pepelepoisson/LaMule/LaMuleV1/Images/LaMule_V1_CAD_eclate.png

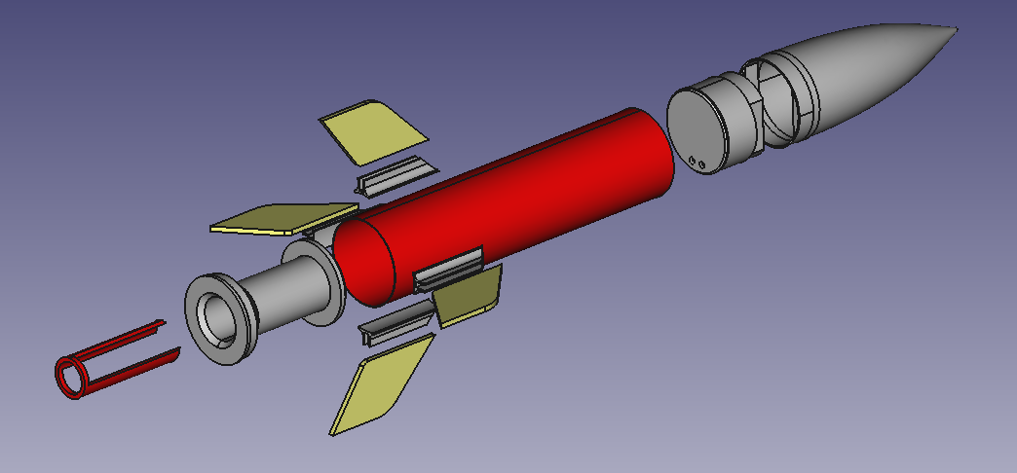
LaMuleV1/Images/LaMule_V1_CAD_eclate.png
