pepelepoisson/LaMule/LaMuleV1/Images/LaMule_V1_post_recuperation.jpg

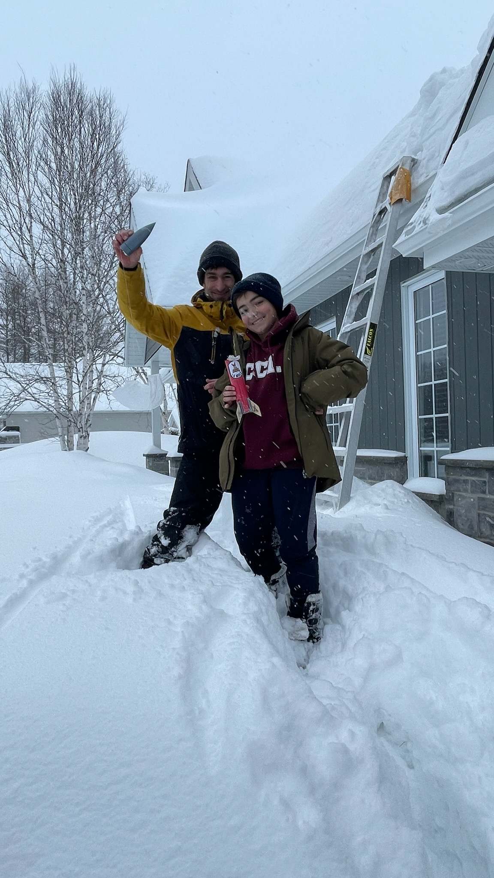
LaMuleV1/Images/LaMule_V1_post_recuperation.jpg
