pepelepoisson/LaMule/LaMuleV1/CAD/Other/coiffe.png

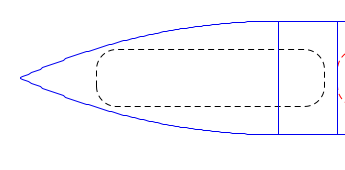
LaMuleV1/CAD/Other/coiffe.png
