pepelepoisson/LaMule/LaMuleV1/Flight_data/LaMule_accelerations_z_vs_phases.png

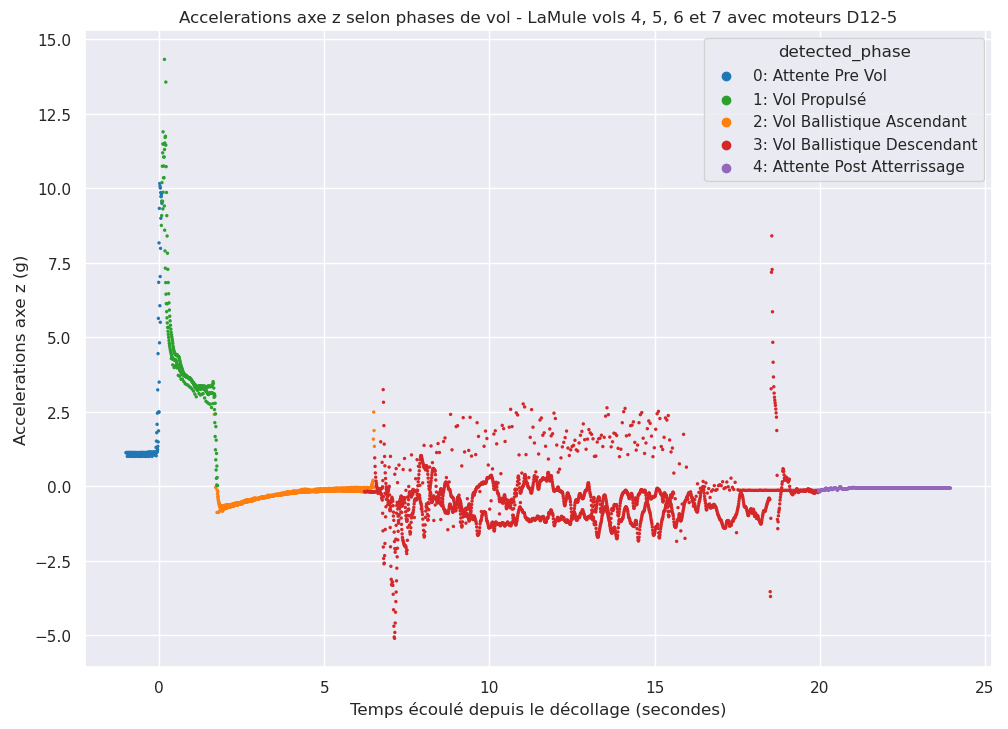
LaMuleV1/Flight_data/LaMule_accelerations_z_vs_phases.png
