pepelepoisson/LaMule/LaMuleV1/Flight_data/LaMule_altitudes_vs_phases.png

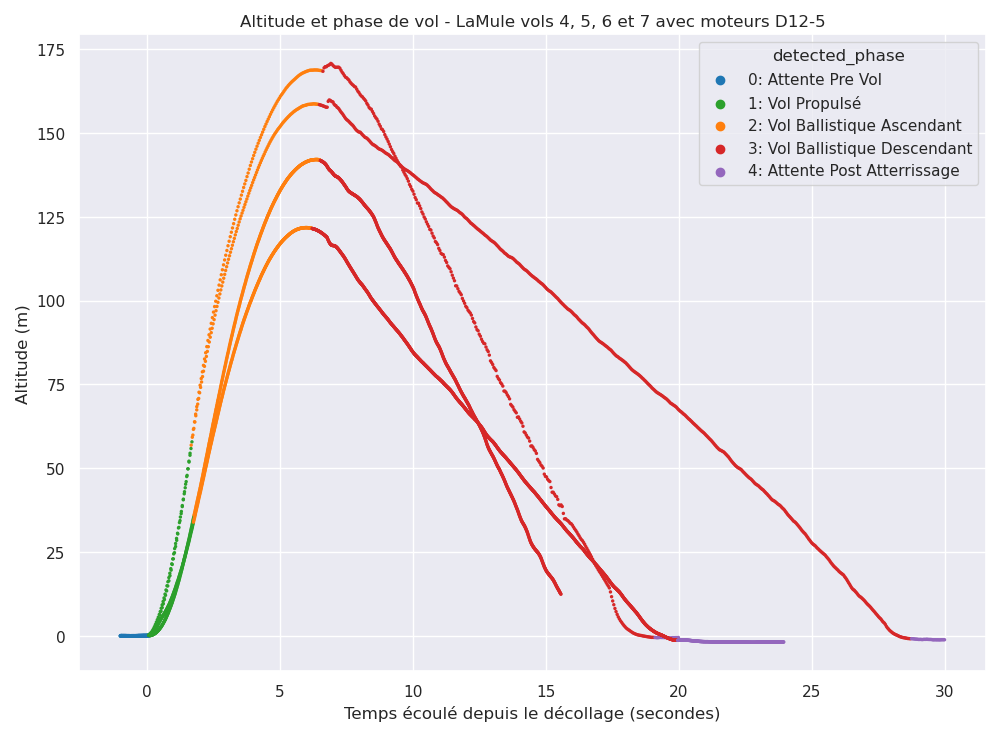
LaMuleV1/Flight_data/LaMule_altitudes_vs_phases.png
