pepelepoisson/LaMule/LaMuleV1/Flight_data/LaMule_altitudes_vs_vols.png

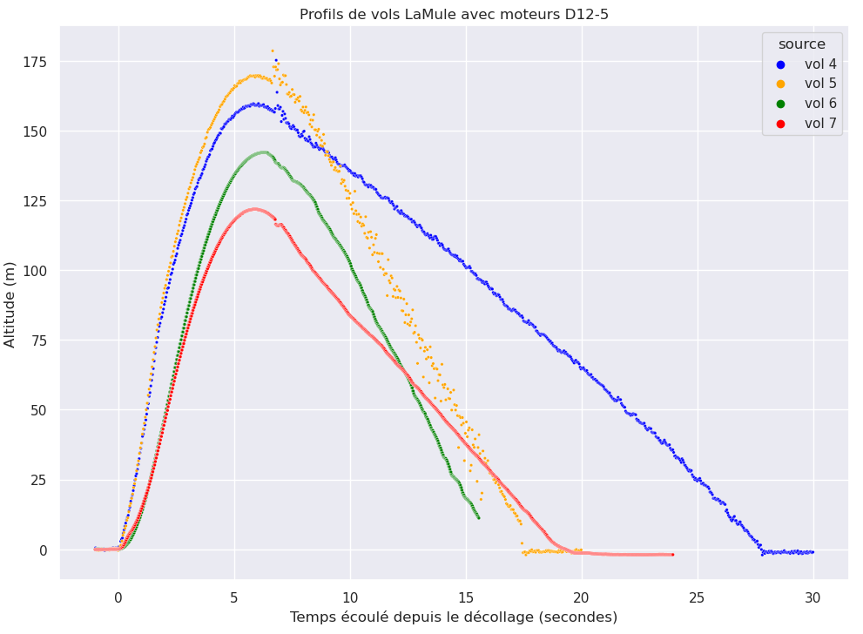
LaMuleV1/Flight_data/LaMule_altitudes_vs_vols.png
