pepelepoisson/LaMule/LaMuleV1/Flight_data/LaMule_vitesses_verticales_vs_phases.png

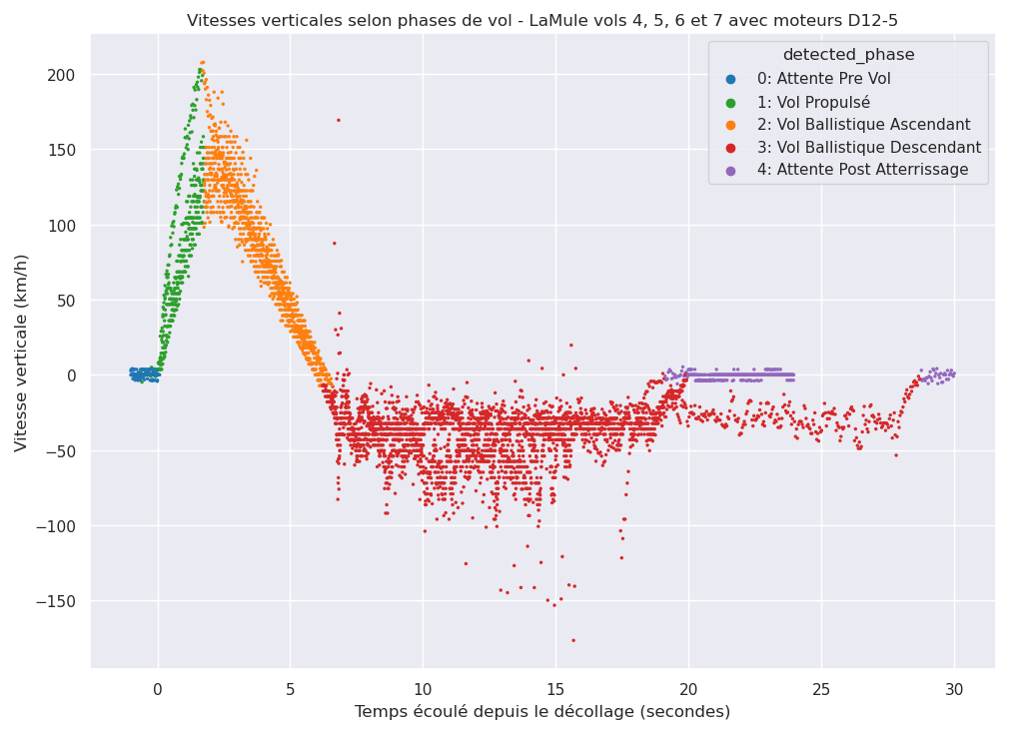
LaMuleV1/Flight_data/LaMule_vitesses_verticales_vs_phases.png
