pepelepoisson/LaMule/LaMuleV1/Flight_data/Profils_acceleration_Z_vols_5_a_7.png

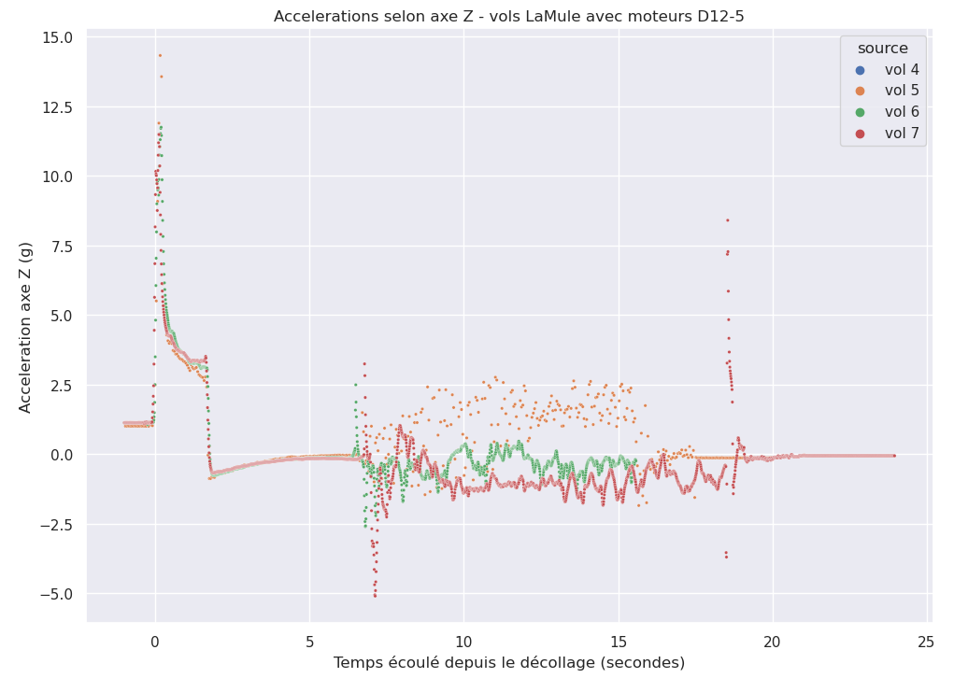
LaMuleV1/Flight_data/Profils_acceleration_Z_vols_5_a_7.png
