pepelepoisson/LaMule/LaMuleV1/Images/800px-EMule_mascot.svg.png

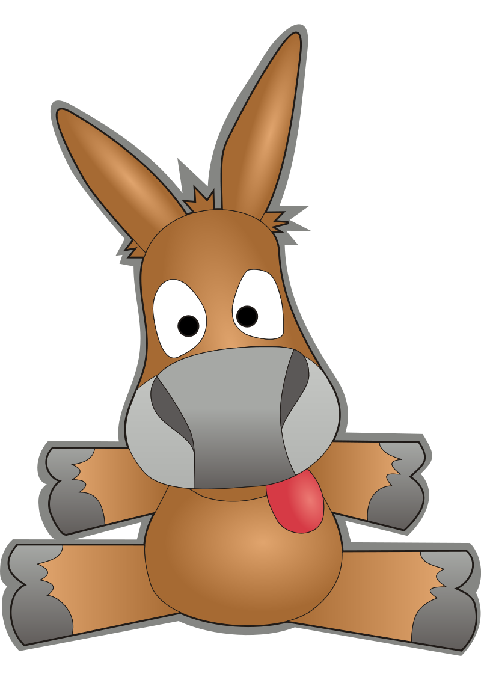
LaMuleV1/Images/800px-EMule_mascot.svg.png
