pepelepoisson/LaMule/LaMuleV1/Images/DSC04824.JPG

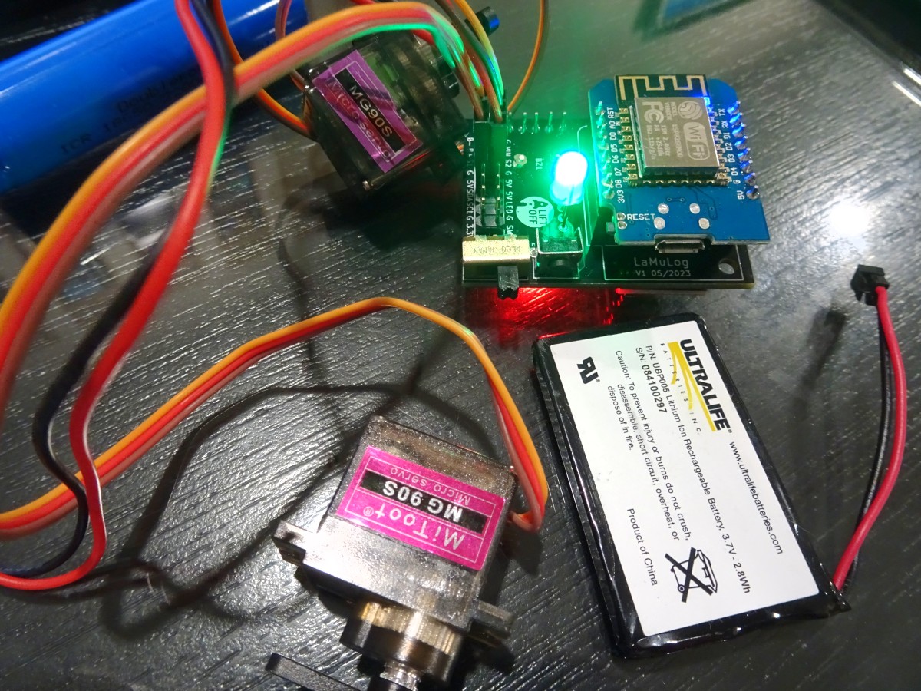
LaMuleV1/Images/DSC04824.JPG
