pepelepoisson/LaMule/LaMuleV1/Images/DSC04825.JPG

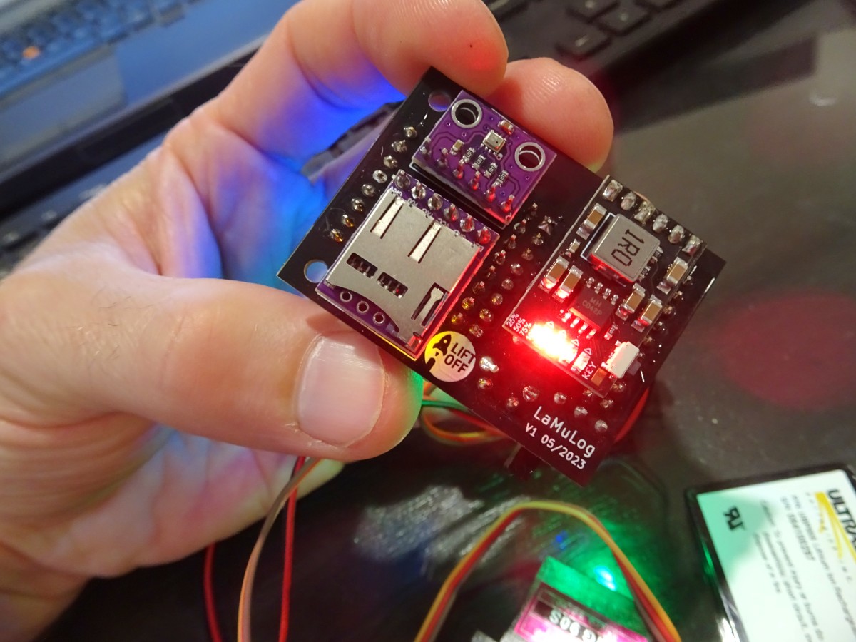
LaMuleV1/Images/DSC04825.JPG
