pepelepoisson/LaMule/LaMuleV1/Images/DSC04826.JPG

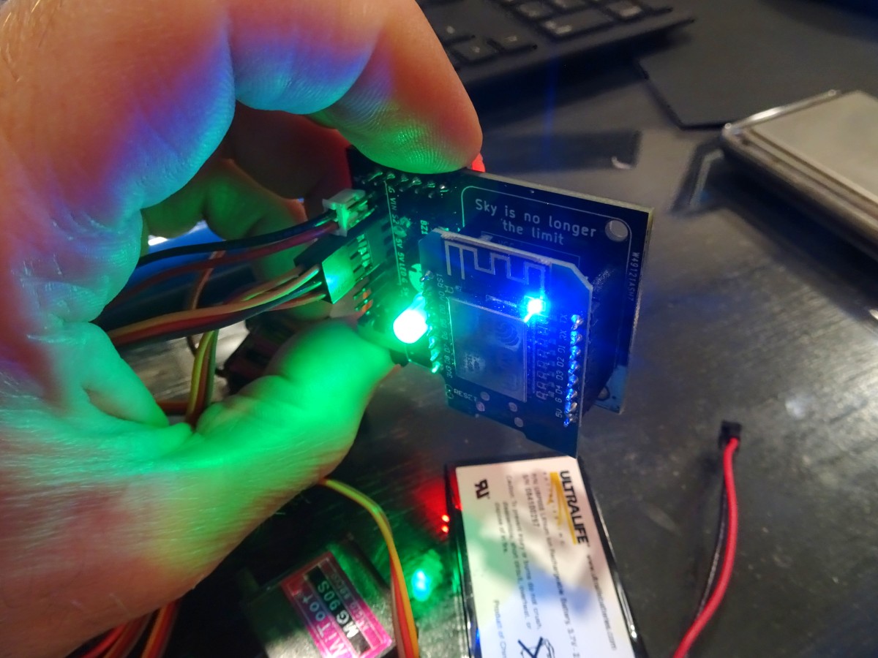
LaMuleV1/Images/DSC04826.JPG
