pepelepoisson/LaMule/LaMuleV1/Images/DSC04827.JPG

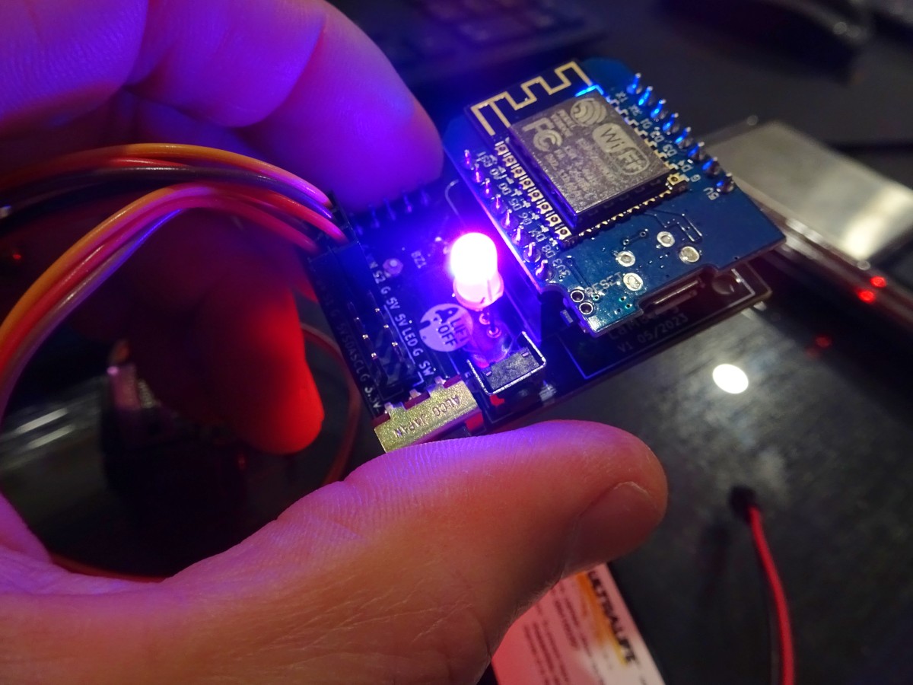
LaMuleV1/Images/DSC04827.JPG
