pepelepoisson/LaMule/LaMuleV1/Images/LacCome.png

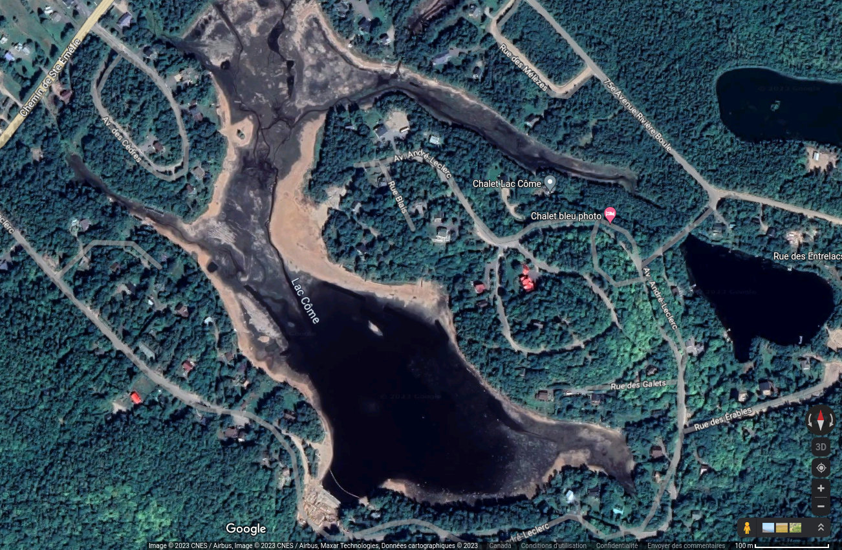
LaMuleV1/Images/LacCome.png
