pepelepoisson/LaMule/LaMuleV1/Images/LaMule_V1_50m.png

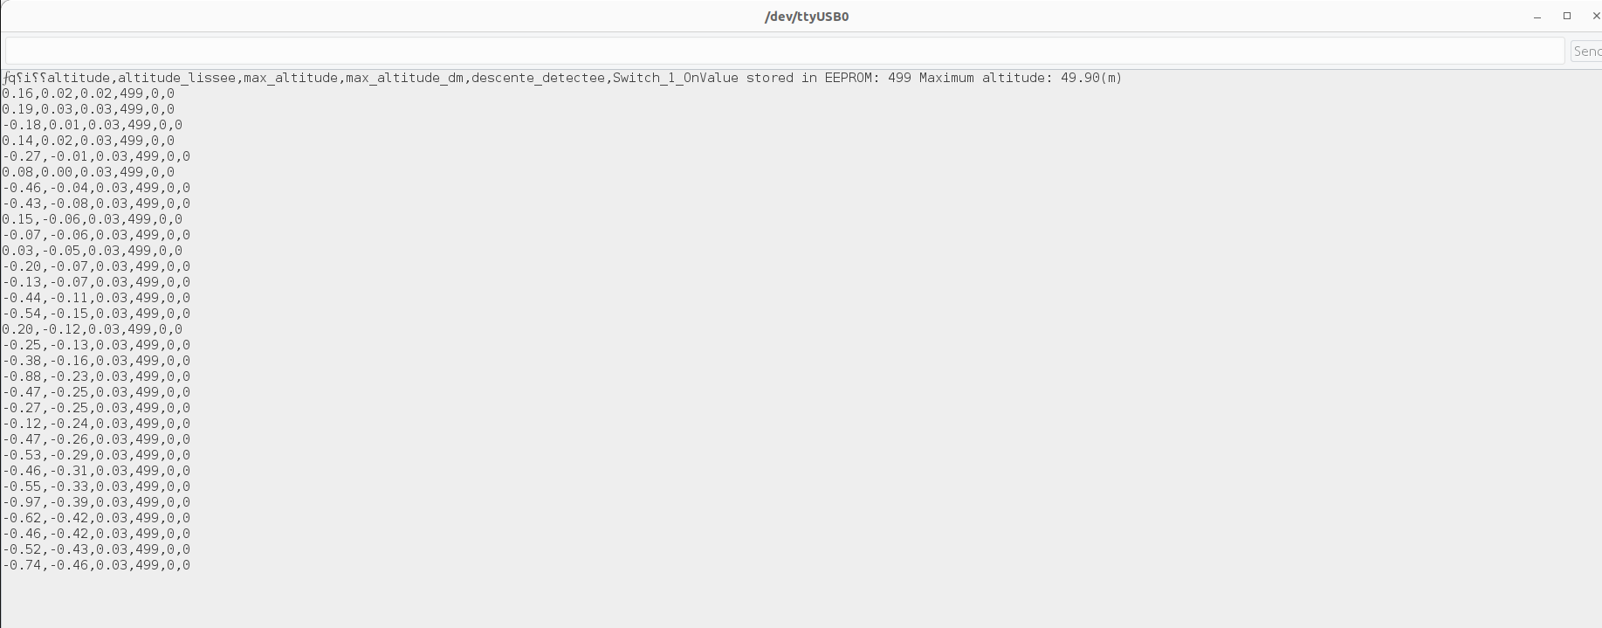
LaMuleV1/Images/LaMule_V1_50m.png
