pepelepoisson/LaMule/LaMuleV1/Images/LaMule_V1_bilan_masse.png

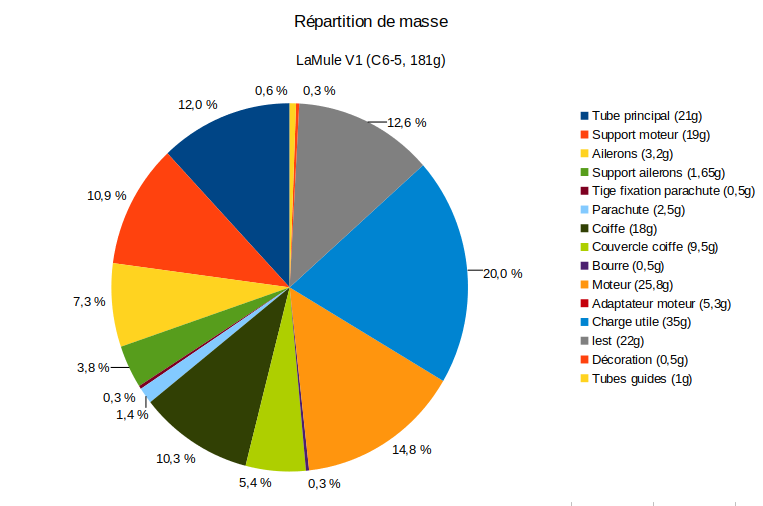
LaMuleV1/Images/LaMule_V1_bilan_masse.png
