pepelepoisson/LaMule/LaMuleV1/Images/LaMule_V1_bilan_masses_simplifie.png

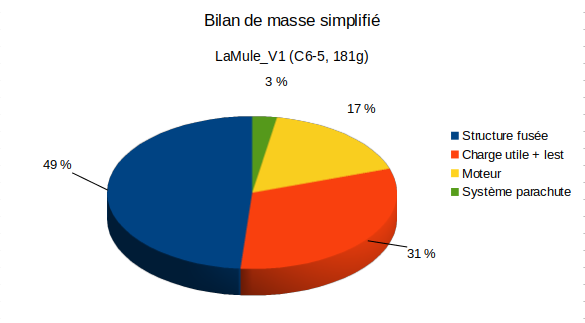
LaMuleV1/Images/LaMule_V1_bilan_masses_simplifie.png
