pepelepoisson/LaMule/LaMuleV1/Images/LaMule_V1_CAD.png

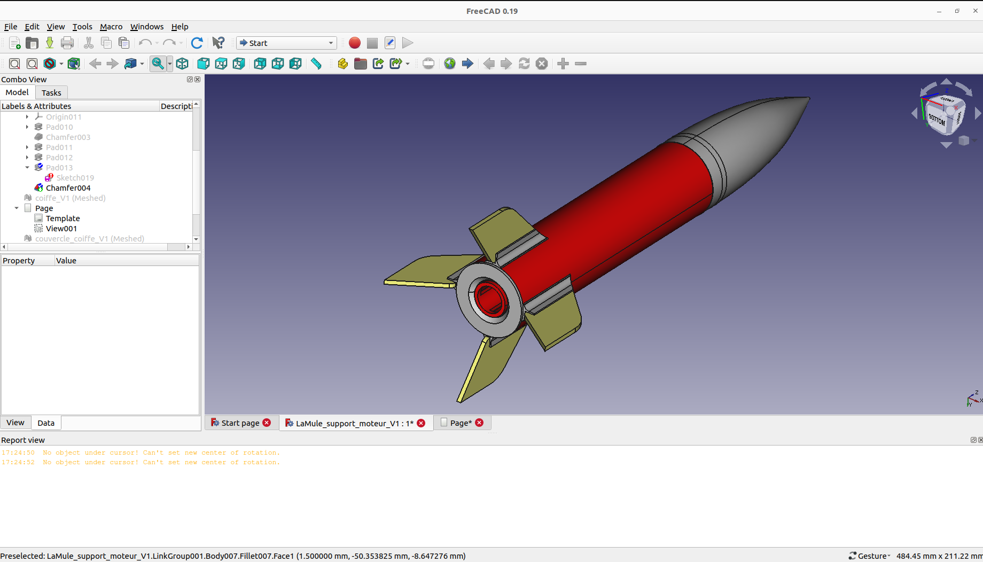
LaMuleV1/Images/LaMule_V1_CAD.png
