pepelepoisson/LaMule/LaMuleV1/Images/LaMule_V1_dessin_technique.png

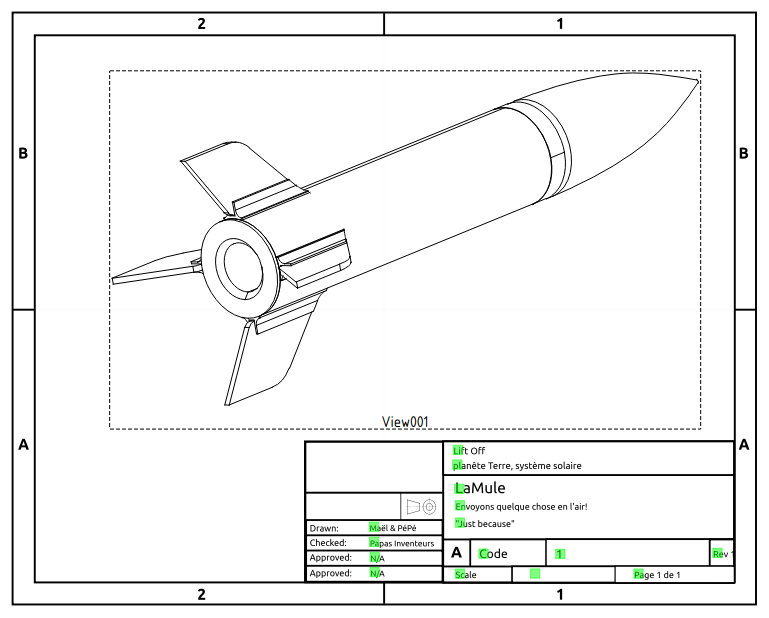
LaMuleV1/Images/LaMule_V1_dessin_technique.png
