pepelepoisson/LaMule/LaMuleV1/Images/LaMule_V1_in_ze_sky.JPG

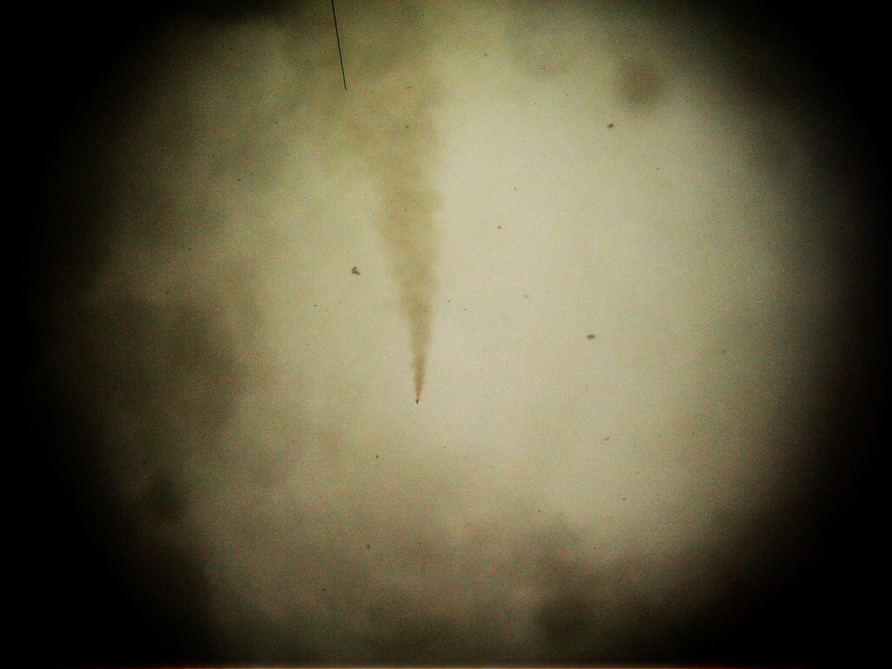
LaMuleV1/Images/LaMule_V1_in_ze_sky.JPG
