pepelepoisson/LaMule/LaMuleV1/Images/LaMule_V1_OpenRocket.png

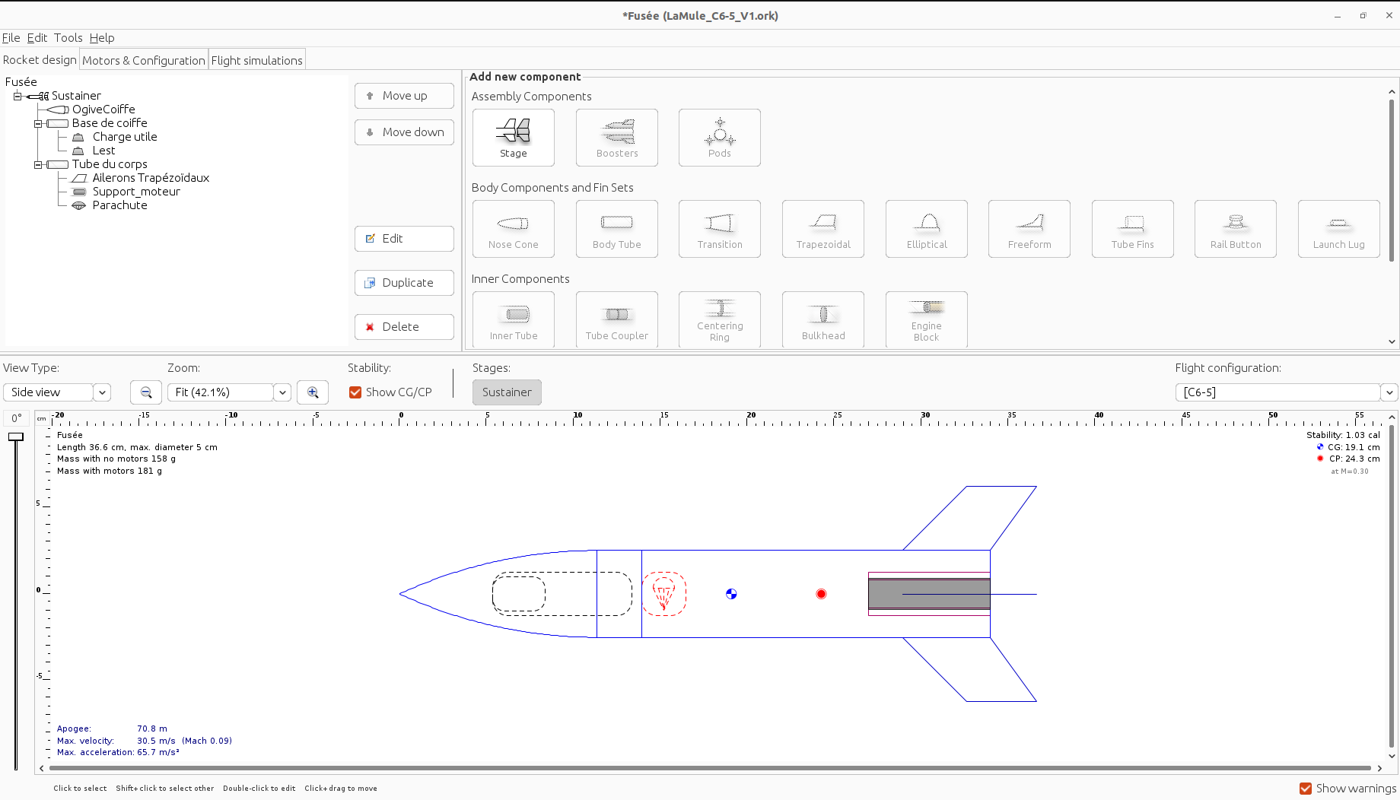
LaMuleV1/Images/LaMule_V1_OpenRocket.png
