pepelepoisson/LaMule/LaMuleV1/Images/LaMule_V1_pre_flight_simulation.png

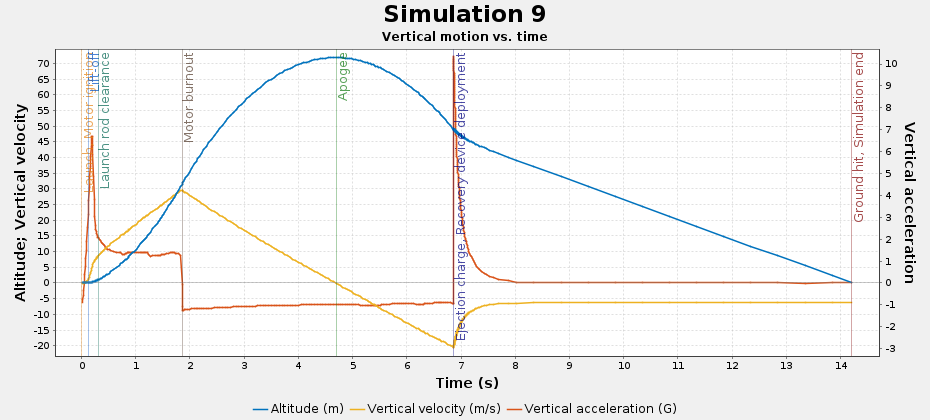
LaMuleV1/Images/LaMule_V1_pre_flight_simulation.png
