pepelepoisson/LaMule/LaMuleV1/Images/LaMule_V1_vitesse_vol1.png

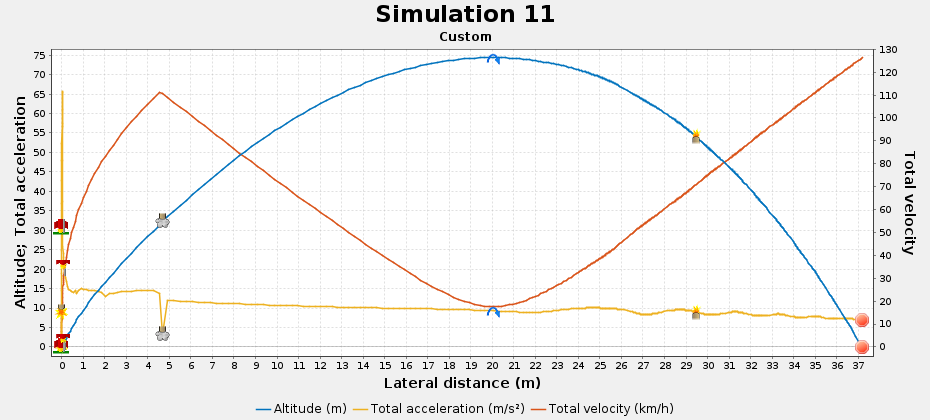
LaMuleV1/Images/LaMule_V1_vitesse_vol1.png
