pepelepoisson/LaMule/LaMuleV1/Images/LaMule_V1_Vol3_post_flight_simulation.png

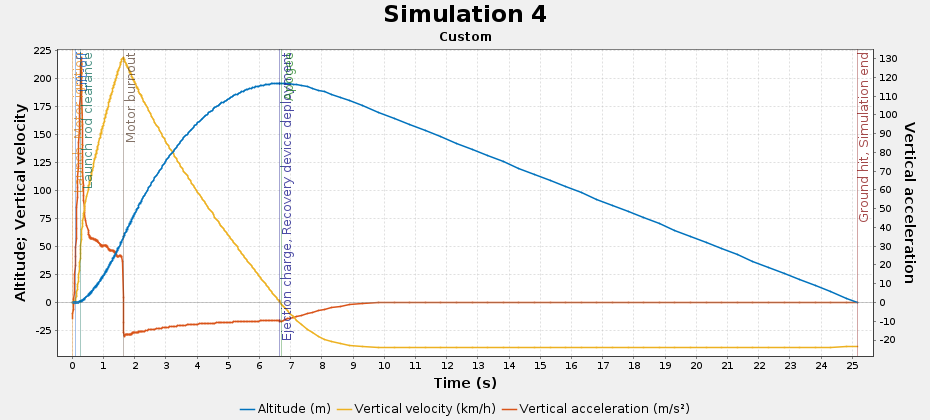
LaMuleV1/Images/LaMule_V1_Vol3_post_flight_simulation.png
