pepelepoisson/LaMule/LaMuleV1/Images/LaMule_Vol3.png

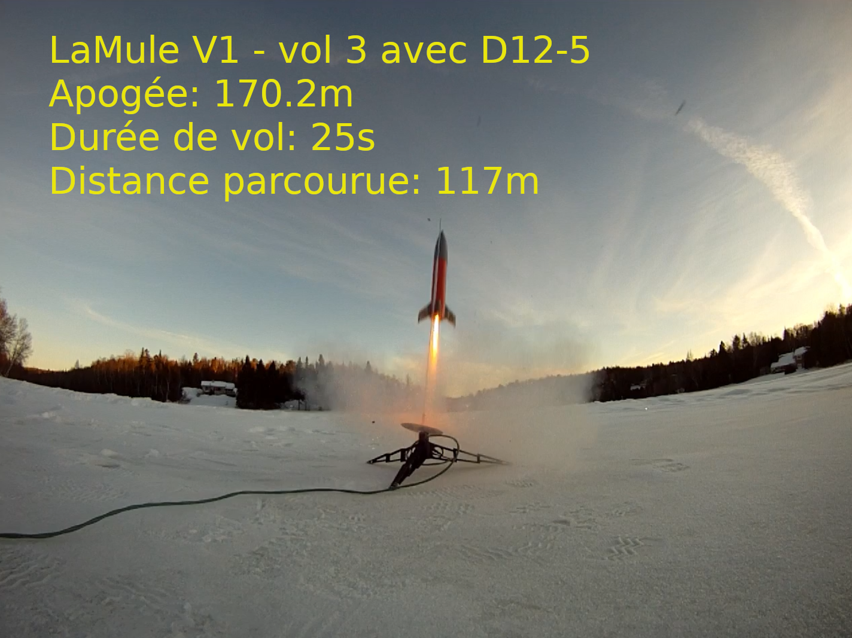
LaMuleV1/Images/LaMule_Vol3.png
