pepelepoisson/LaMule/LaMuleV1/Images/LaMule_Vol4_parachute.png

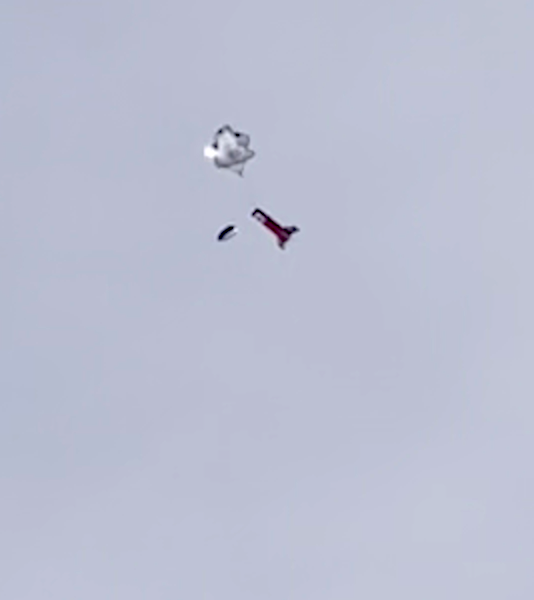
LaMuleV1/Images/LaMule_Vol4_parachute.png
