pepelepoisson/LaMule/LaMuleV1/PCB/LaMulog_esp_compact/3Dmodels/BME280_SENSOR_MODULE.JPG

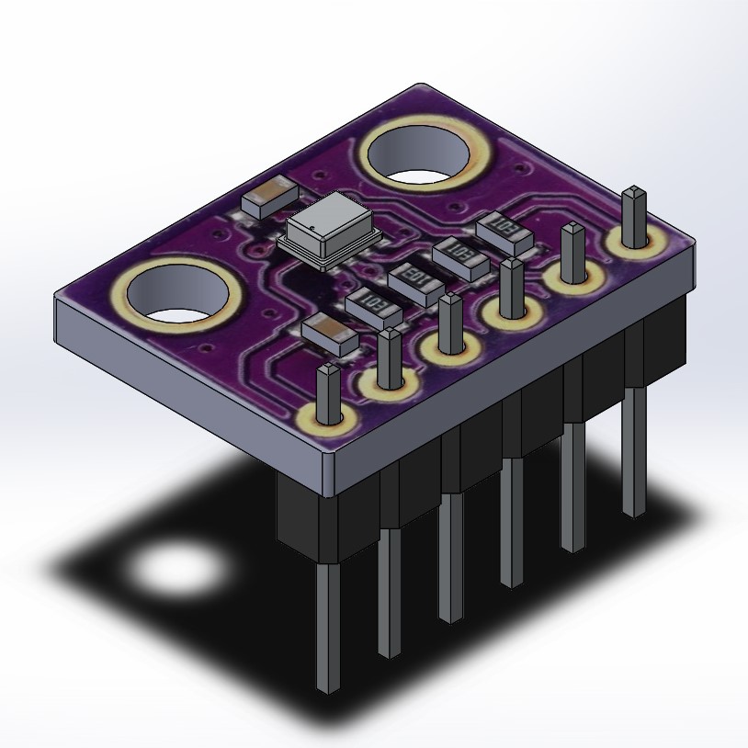
LaMuleV1/PCB/LaMulog_esp_compact/3Dmodels/BME280_SENSOR_MODULE.JPG
