pepelepoisson/LaMule/LaMuleV1/PCB/LaMulog_esp_compact/3Dmodels/MPU 6050 IMU v1.png

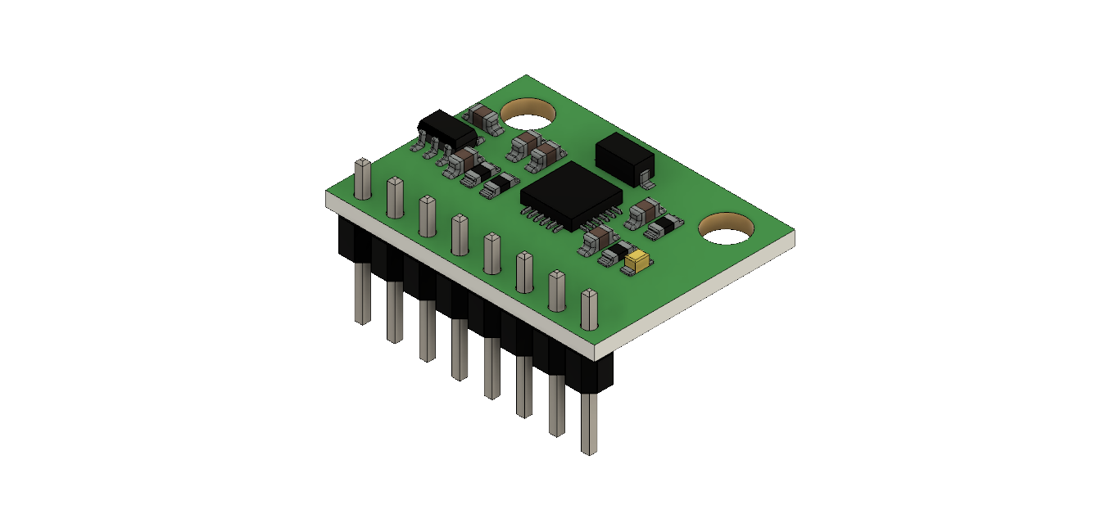
LaMuleV1/PCB/LaMulog_esp_compact/3Dmodels/MPU 6050 IMU v1.png
