pepelepoisson/LaMule/LaMuleV1/PCB/LaMulog_esp_compact/3Dmodels/overview.jpg

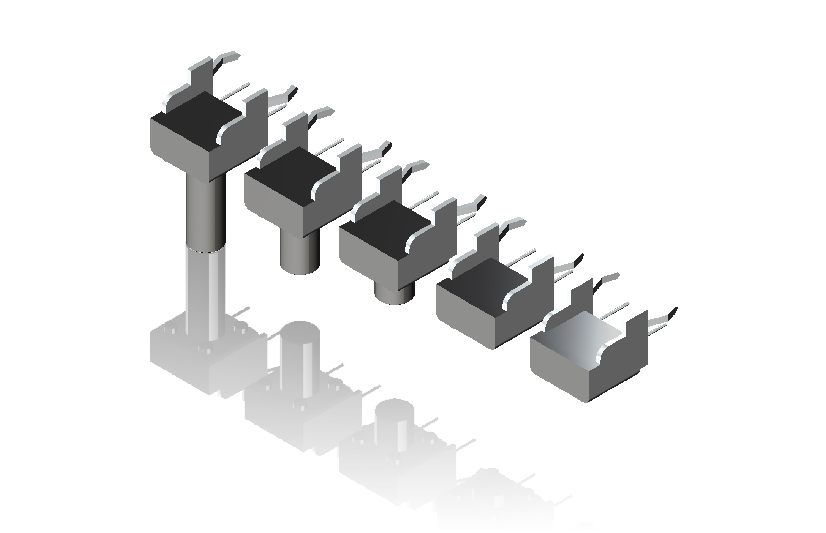
LaMuleV1/PCB/LaMulog_esp_compact/3Dmodels/overview.jpg
