pepelepoisson/LaMule/LaMuleV1/PCB/LaMulog_esp_compact/3Dmodels/switch.PNG

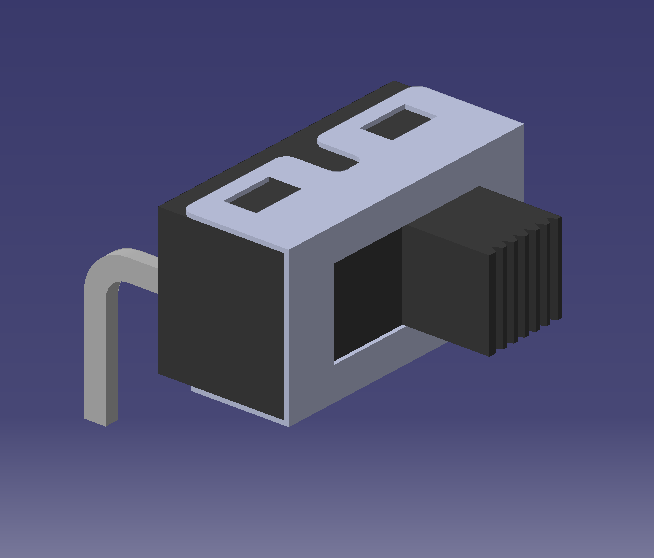
LaMuleV1/PCB/LaMulog_esp_compact/3Dmodels/switch.PNG
