pepelepoisson/LaMule/Projet_fusee.ods

Sheet: Budget de poids électronique
Charges utiles : |  | Masse (g) | dimensions (mm) |  | Energie (Wh) | Concept 1 | Concept 2 | Concept 3
Batteries | Lipo 520mA 3.7V | 10.6 | 49x19x7 |  | 1.924 | 10.6 | 10.6 | 10.6
 | Lipo 756mAh 3.7V | 19.3 | 31x51x6 |  | 2.7972
 | Lipo 18650 2200mAh 3.7V | 48 | 18x650 |  | 8.14
Camera | SQ11 avec micro SD | 10.7 |  |  |  | 10.7 | 10.7
MCU | Nano | 6 | 43x18x8
 | Nano avec radio | 5.3 | 45x18x12
 | Pro mini | 4 | 34x19x5 |  |  | 4 | 4 | 4
Instrumentation | Altimetre GY-BM ME/PM 280 | 1 | 16x12x3 |  |  | 1 | 1
 | Accelerometre GY-521 | 2 | 21x16x3 |  |  | 2 | 2 | 2
Datalogger | Arduino nano logger + RTC | 14 | 94x26x20
 | ID-8122 | 7 | 37x34x6 |  |  | 7 |  | 7
 | Openlog | 3 | 20x16x5 |  |  |  | 3
Servos | MG90S | 11.4 | 32x13x13
Radio | NRF2401 | 2 | 29x16x12 |  |  |  |  | 2
 | NRF2401 grand portee | 10.8 | 49x16x14 | plus antenne 108x10 |  | 10.8 | 10.8
PCB | Breadboard | 4.5 | 80x20x1.6 |  |  | 4.5 | 4.5
Fils etc. |  | 5 |  |  |  | 5 | 5 | 5
Boitier |  | 10 |  |  |  | 10 | 10
Toral |  |  |  |  |  | 65.6 | 61.6 | 30.6
Moteurs :
D12 | https://estesrockets.com/product/001568-d12-7-engines/
 |  |  |  |  |  |  |  | 33.782
2.77623 | 3.60200703832175
5.41257340802685

Sheet: Moteurs
 | 19.6912
 | 58.3 | g
 | 58 | cm
 | 5 | couches
Poids par cm | 1.01 | g
 | 3.6144578313253

Sheet: LaMule_V1.1
Configuration utilisée pour les vols 1 et 2
Bilan de masse |  |  |  |  |  |  |  |  | Vols
Élément | masse unitaire(g) | quantité | masse combinée (g) | Variante | Description |  | Élément | masse combinée (g) | # | Date | Lieu | Configuration | Poids (g) | Apogée (m) | Durée (s) | Distance chute (m) | Trajectoire | Déploiement parachute | Dommages | Notes
Tube principal | 21 | 1 | 21 | 1 | 5 épaisseurs de kraft rouge, colle à bois, diamètre extérieur 50mm, longueur 200mm |  | Tube principal (21g) | 21 | 1 | 2023-03-04 | Lac Côme | V1, C6-5, 181g, altimètre V1 | 181 | 50 |  |  | Stable | Échec | Deux ailerons décollés. | Atterrissage sur le toit du chalet!
Support moteur | 19 | 1 | 19 | 1 | PLA |  | Support moteur (19g) | 19 | 2 | 2023-03-05 | Lac Côme | V1, C6-5, 181g, altimètre V1 | 181 | 3.1 |  | 80 | Stable | Échec | Cône endommagé. | Altimètre n’a pas fonctionné. Atterrissage dans la neige a 80m du pas de tir. Belle vidéo du décollage.
Ailerons | 3.2 | 4 | 12.8 |  |  |  | Ailerons (3,2g) | 12.8 | 3 | 2023-03-11 | Lac Côme | V1, D12-5, altimètre V2, inclinaison 5 degrés. |  | 170.2 | 25.24 | 117 | Stable | Réussi mais n’ouvre pas complètement (fondu) | Un aileron décollé. Parachute partiellement fondu. | Module log mal branché – log non enregistré mais altitude maximale disponible dans la mémoire EEPROM du nano. Le pas de tir bouge latéralement d’un pied au décollage.
Support ailerons | 1.65 | 4 | 6.6 | 1 |  |  | Support ailerons (1,65g) | 6.6 | 4 | 2023-03-12 | Lac Côme | V1, D12-5, altimètre V2, inclinaison 5 degrés. | 214.5 | 160 | 28 | 35 | Stable | Succès total! | Un aileron presque décollé. | Succès! Enregistrement de l’altitude de vol 27 fois par seconde.
Tige fixation parachute | 0.5 | 1 | 0.5 |  |  |  | Tige fixation parachute (0,5g) | 0.5 | 5 | 2023-03-26 | Lac Côme | V1, D12-5, électronique V3 (altimètre + acceleromètre + SD), inclinaison 5 degrés. | 215.5 | 170 | 17.5 | 150 | Stable | Succès mais la coiffe se détache du reste et tombe en chute libre. | Rien mais atteri en 2 morceaux. | Succès! Enregistrement de l’altitude de vol et des données MPU6050 environ 24 fois par seconde. Fusée perdue en haut d’un sapin pendant quelques heures, récupération épique et miraculeuse!
Parachute | 2.5 | 1 | 2.5 |  |  |  | Parachute (2,5g) | 2.5 | 6 | 2023-11-26 | Saint-Lin | V1, D12-5, LamuLog V1 (altimètre + acceleromètre + SD), inclinaison 5 degrés. | 236 | 142 | 16.5 |  | Stable | Le cône est éjécté mais le parachute reste dans le tube de fusée et est endomagé par la chaleur. | 3 ailerons décollés. | Succès du premier test du module LaMulog mais le fichier de log est interrompu bievement au moment du choc de retour à terre (pas de parachute). Altitude maximum consultée immédiatement après le vol via WiFi et page web consultée par ordinateur.
Coiffe | 18 | 1 | 18 |  |  | 1.05882352941176 | Coiffe (18g) | 18 | 7 | 2023-11-26 | Saint-Lin | V1, D12-5, LamuLog V1 (altimètre + acceleromètre + SD), inclinaison 5 degrés. | 236 | 122 | 20 |  | Instable initialement | Le parachute sommairement réparé se déploie partiellement. | Aucun;-) | Succès du premier test du module LaMulog. Altitude maximum consultée immédiatement après le vol via WiFi et page web consultée sur téléphone.
Couvercle coiffe | 9.5 | 1 | 9.5 |  |  |  | Couvercle coiffe (9,5g) | 9.5
Bourre | 2 | 1 | 2 |  |  |  | Bourre (0,5g) | 0.5
Moteur | 25.8 | 1 | 25.8 |  | C6-5 |  | Moteur (25,8g) | 25.8
Adaptateur moteur | 5.3 | 1 | 5.3 | 2 |  |  | Adaptateur moteur (5,3g)
Charge utile | 35 | 1 | 35 |  |  |  | Charge utile (35g) | 35
lest | 22 | 1 | 22 |  |  |  | lest (22g) | 22
Décoration | 0.5 | 1 | 0.5 |  |  |  | Décoration (0,5g) | 0.5
Tubes guides | 1 | 1 | 1 |  |  |  | Tubes guides (1g) | 1
Total théorique |  |  | 181.5
Total constaté |  |  | 181 |  |  |  |  |  | Observations :
Total open rocket |  |  | 181 |  | 3.6 |  |  |  | Remplacer le dispositif d’ancrage des lignes de parachute pour éviter le blocage de la bourre.
Poussée | Poussé moyenne (N) |  | Poids decollage (N) | Ratio poids/poussée |  |  |  |  | Pre-flight check list :
C6-5 | 6 |  | 1.8 | 3.37 |  |  |  |  | Branchements altimètre
 |  |  |  |  |  |  |  |  | Pas de tir stable en place
Bilan de masse simplifié
Sous-ensemble | masse (g)
Structure fusée | 88.4
Charge utile + lest | 57 |  |  |  |  |  | Altimetre | I2C device found at address 0x77
Moteur | 31.1 |  |  |  |  |  | Accéléromètre | I2C device found at address 0x68
Système parachute | 5
Total | 181.5 | 0
Configuration utilisée pour le vol 3
Bilan de masse
Élément | masse unitaire(g) | quantité | masse combinée (g) | Variante | Description
Tube principal | 21 | 1 | 21 | 1 | 5 épaisseurs de kraft rouge, colle à bois, diamètre extérieur 50mm, longueur 200mm
Support moteur | 19 | 1 | 19 | 1 | PLA
Ailerons | 3.2 | 4 | 12.8
Support ailerons | 1.65 | 4 | 6.6 | 1
Tige fixation parachute | 0.5 | 1 | 0.5
Parachute | 5 | 1 | 5
Coiffe | 18 | 1 | 18
Couvercle coiffe | 9.5 | 1 | 9.5
Bourre | 2 | 1 | 2
Moteur | 43.1 | 1 | 43.1 |  | D12-5
Moteur | 25.8 | 0 | 0 |  | C6-5
Adaptateur moteur | 10.8 | 0 | 0 | 1
Adaptateur moteur | 5.3 | 0 | 0 | 2
Charge utile | 35 | 1 | 35
lest | 22 | 1 | 22
Décoration | 0.5 | 1 | 0.5
Tubes guides | 1 | 1 | 1
Total théorique |  |  | 196
Total constaté |  |  | 181
Total open rocket |  |  | 181 |  | 3.6
