pepelepoisson/LaMule/LaMuleV1/PCB/LaMulog_esp_compact/3Dmodels/OpenLog/OpenLog - pins up.SLDASM

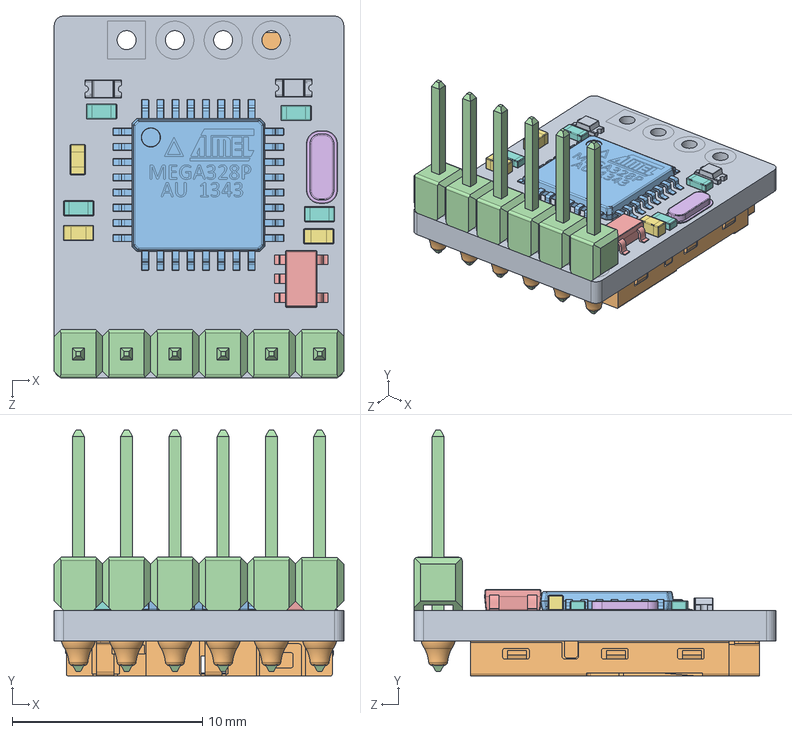
[picture p32: CAD file, 2023-12-13]
LaMuleV1/PCB/LaMulog_esp_compact/3Dmodels/OpenLog/OpenLog - pins up.SLDASM
15.2 x 12.9 x 19.1 mm
OpenLog_PCB
microSDslot.stp
ATmega
Pin Header 1x6 TH Pitch 2.54mm
SOT23-5
cap_603 x 3
res_603 x 4
Surface Mount Chip LED 3.2x1.6mm x 2
solder x 6
