pepelepoisson/LaMule/LaMuleV1/PCB/LaMulog_esp_compact/3Dmodels/OpenLog/OpenLog - basic.SLDASM

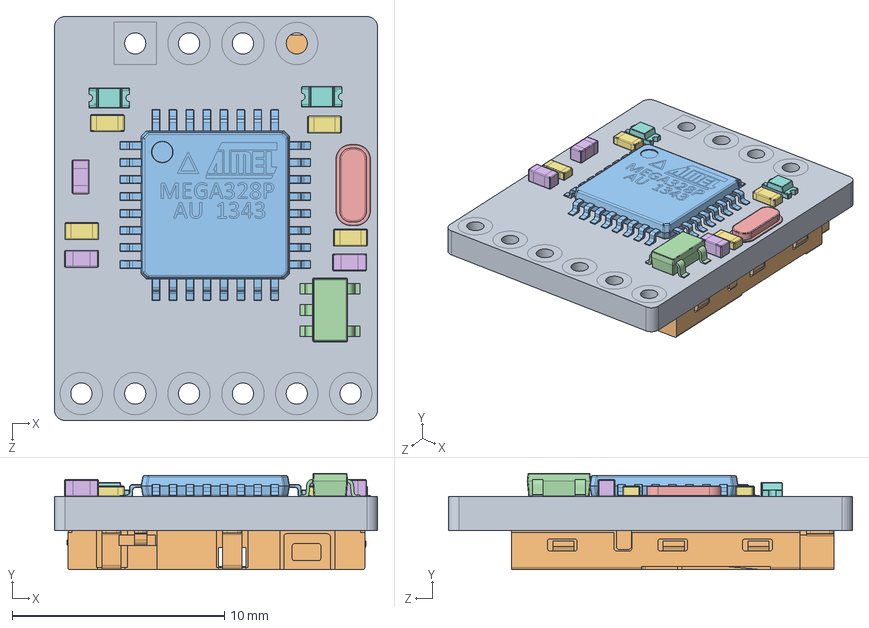
[picture p33: CAD file, 2023-12-13]
LaMuleV1/PCB/LaMulog_esp_compact/3Dmodels/OpenLog/OpenLog - basic.SLDASM
15.2 x 4.55 x 19.1 mm
OpenLog_PCB
microSDslot.stp
ATmega
SOT23-5
cap_603 x 3
res_603 x 4
Surface Mount Chip LED 3.2x1.6mm x 2
