pepelepoisson/LaMule/LaMuleV1/CAD/FreeCAD/LaMule_V1.3.FCStd

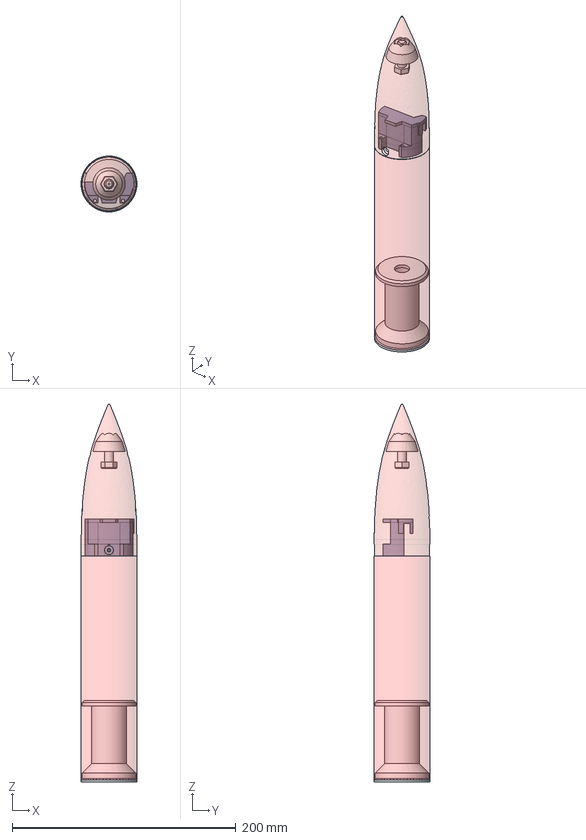
[picture p34: CAD file, 2023-12-13]
LaMuleV1/CAD/FreeCAD/LaMule_V1.3.FCStd
50.0 x 50.0 x 338.0 mm
support_moteur_V1
tube_V1
coiffe_V002
couvercle_coiffe_V003
FixationLaMulog
Support lest
Boulon support lest
Ecrou support lest
