pepelepoisson/LaMule/LaMuleV1/CAD/stl files/LaMule_coiffe_V3.stl

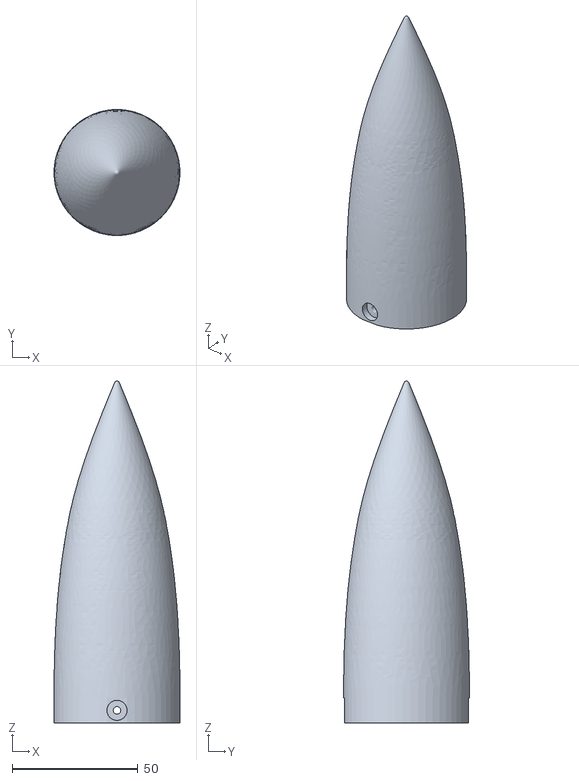
[picture p35: CAD file, 2023-12-13]
LaMuleV1/CAD/stl files/LaMule_coiffe_V3.stl
49.9 x 50.0 x 135.7
