pepelepoisson/LaMule/LaMuleV1/PCB/LaMulog_esp_compact/3Dmodels/GY-BME/P280, 6-PIN-Version v4.step

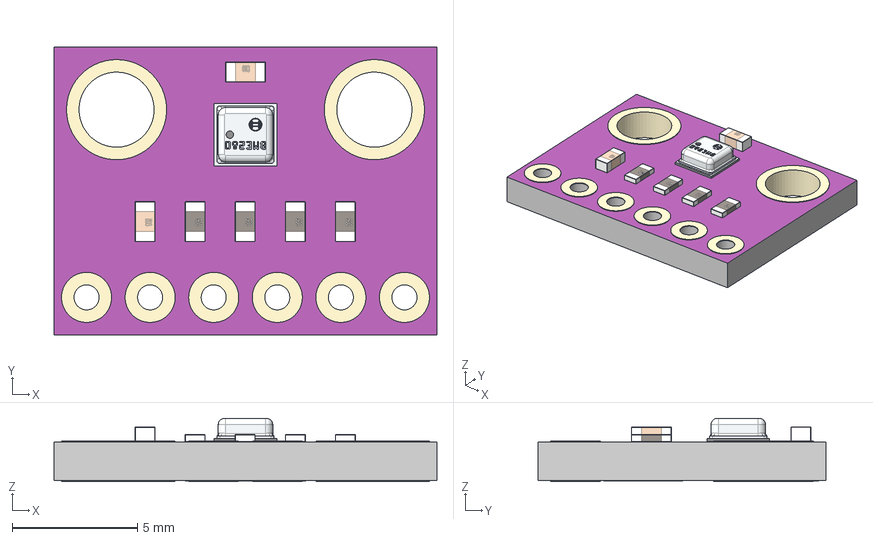
[picture p36: CAD file, 2023-12-13]
LaMuleV1/PCB/LaMulog_esp_compact/3Dmodels/GY-BME/P280, 6-PIN-Version v4.step
15.3 x 11.5 x 2.52 mm
Komponente1
Komponente2
Komponente3
Komponente4
Komponente5
Komponente6
Komponente7
Komponente8
Beschriftung
C0603 x 2
R0603 x 4
BME280
