pepelepoisson/LaMule/LaMuleV1/PCB/LaMulog_esp_compact/3Dmodels/MPU 6050 IMU v1.stl

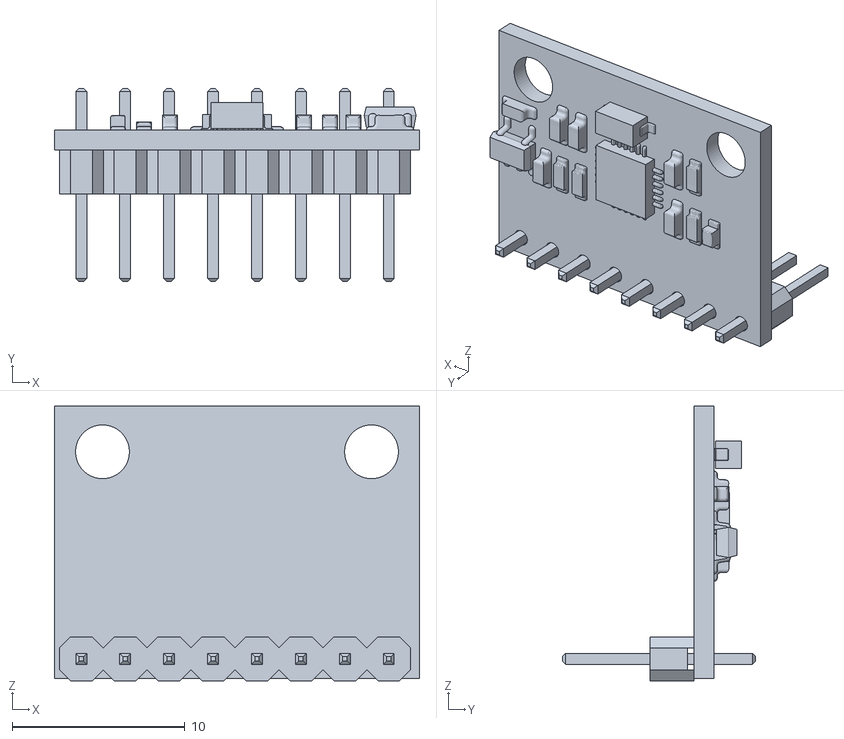
[picture p37: CAD file, 2023-12-13]
LaMuleV1/PCB/LaMulog_esp_compact/3Dmodels/MPU 6050 IMU v1.stl
21.1 x 11.2 x 15.9
