pepelepoisson/LaMule/LaMuleV1/PCB/LaMulog_esp_compact/3Dmodels/OpenLog/Components/ATmega328 TQFP/ATmega.SLDPRT

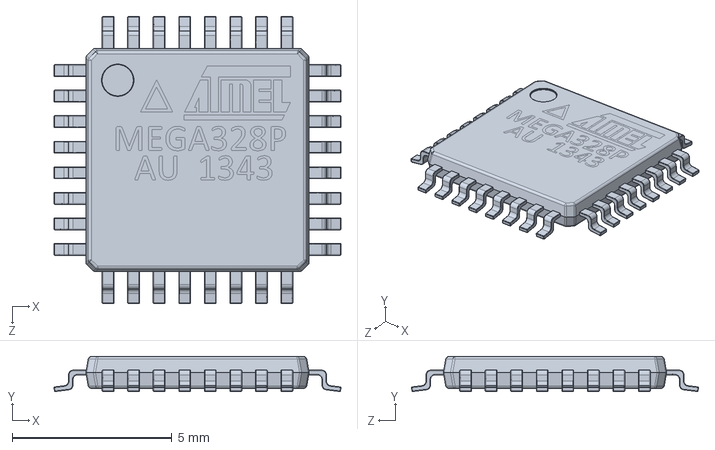
[picture p38: CAD file, 2023-12-13]
LaMuleV1/PCB/LaMulog_esp_compact/3Dmodels/OpenLog/Components/ATmega328 TQFP/ATmega.SLDPRT
9.00 x 1.10 x 9.00 mm
