pepelepoisson/LaMule/LaMuleV1/PCB/LaMulog_esp_compact/3Dmodels/OpenLog/Components/Pin Header 1x6 TH Pitch 2.54mm.SLDPRT

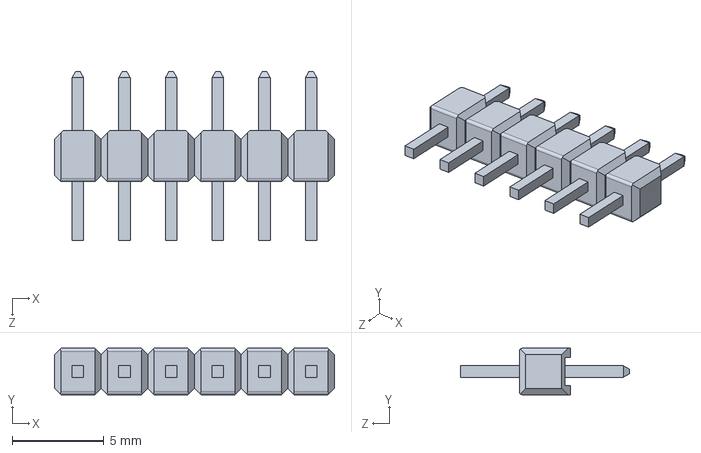
[picture p39: CAD file, 2023-12-13]
LaMuleV1/PCB/LaMulog_esp_compact/3Dmodels/OpenLog/Components/Pin Header 1x6 TH Pitch 2.54mm.SLDPRT
15.2 x 2.54 x 9.20 mm
