pepelepoisson/LaMule/LaMuleV1/PCB/LaMulog_esp_compact/3Dmodels/stp/SW-DTSA-65K-V.stp

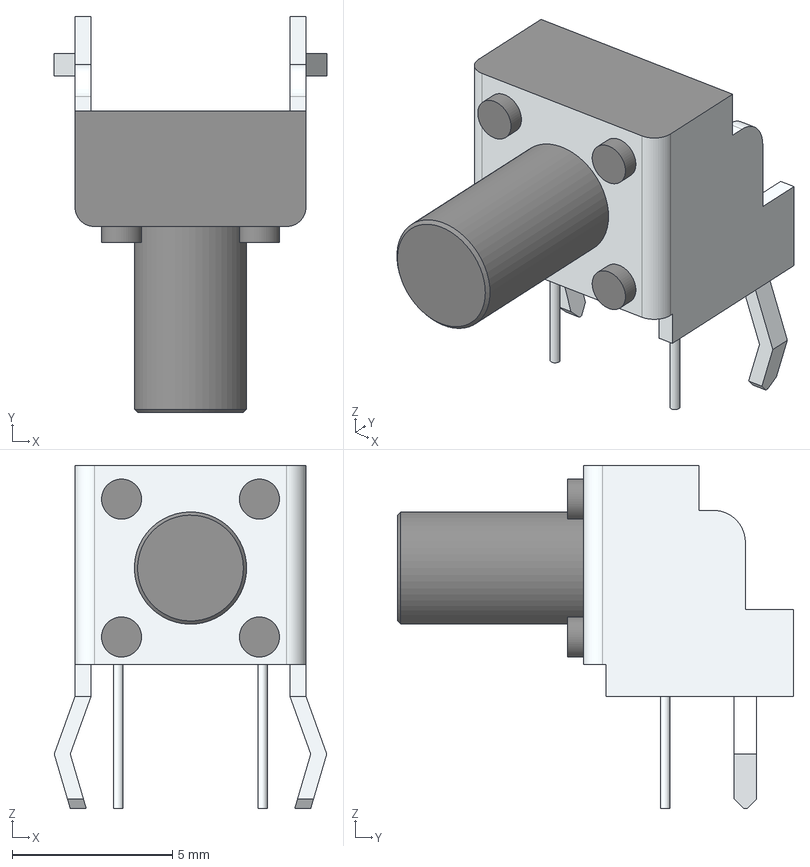
[picture p40: CAD file, 2023-12-13]
LaMuleV1/PCB/LaMulog_esp_compact/3Dmodels/stp/SW-DTSA-65K-V.stp
8.50 x 12.3 x 10.7 mm
