pepelepoisson/LaMule/LaMuleV1/PCB/LaMulog_esp_compact/3Dmodels/OpenLog/Components/OpenLog_PCB.SLDPRT

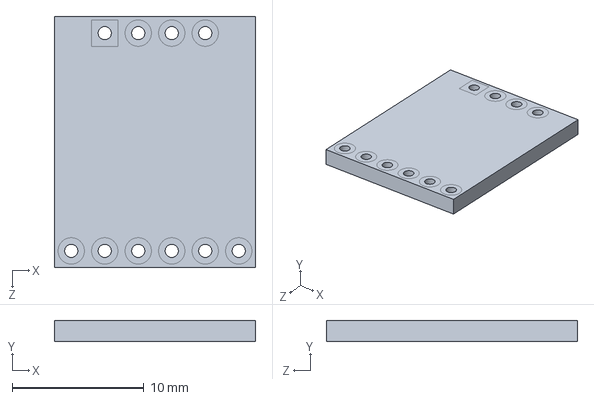
[picture p41: CAD file, 2023-12-13]
LaMuleV1/PCB/LaMulog_esp_compact/3Dmodels/OpenLog/Components/OpenLog_PCB.SLDPRT
15.2 x 1.60 x 19.1 mm
