pepelepoisson/LaMule/LaMuleV1/PCB/LaMulog_esp_compact/3Dmodels/ss12f44g4.stp

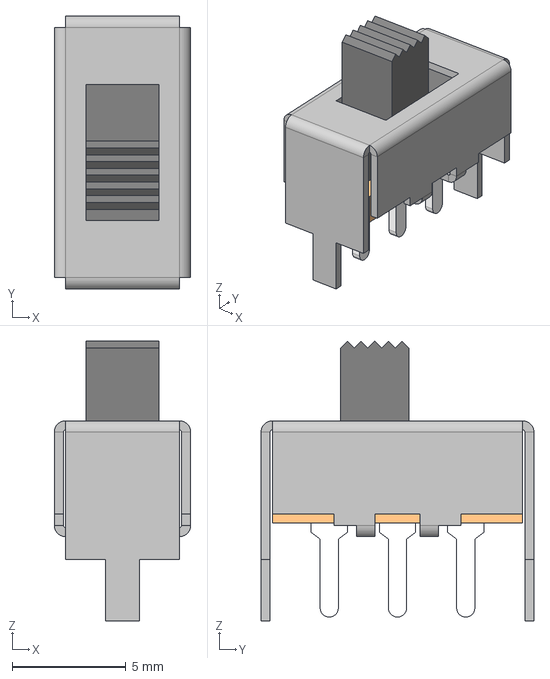
[picture p42: CAD file, 2023-12-13]
LaMuleV1/PCB/LaMulog_esp_compact/3Dmodels/ss12f44g4.stp
6.00 x 12.0 x 12.3 mm
