pepelepoisson/LaMule/LaMuleV1/PCB/LaMulog_esp_compact/3Dmodels/stp/SW-DTSA-66K-V.stp

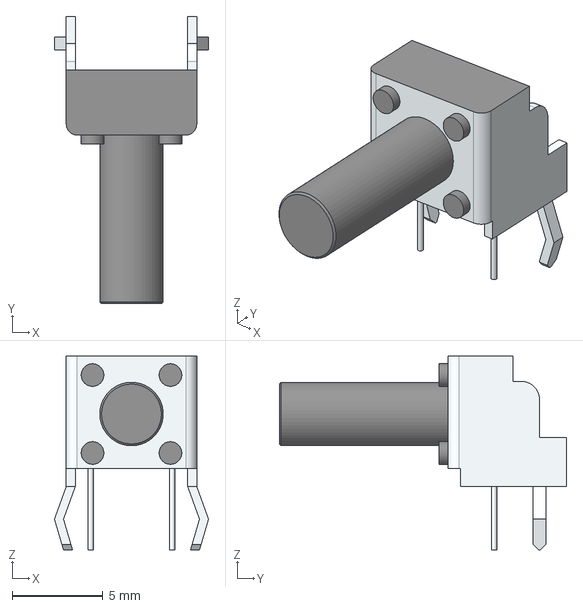
[picture p43: CAD file, 2023-12-13]
LaMuleV1/PCB/LaMulog_esp_compact/3Dmodels/stp/SW-DTSA-66K-V.stp
8.50 x 15.8 x 10.7 mm
