pepelepoisson/LaMule/LaMuleV1/PCB/LaMulog_esp_compact/3Dmodels/MPU_6050.step

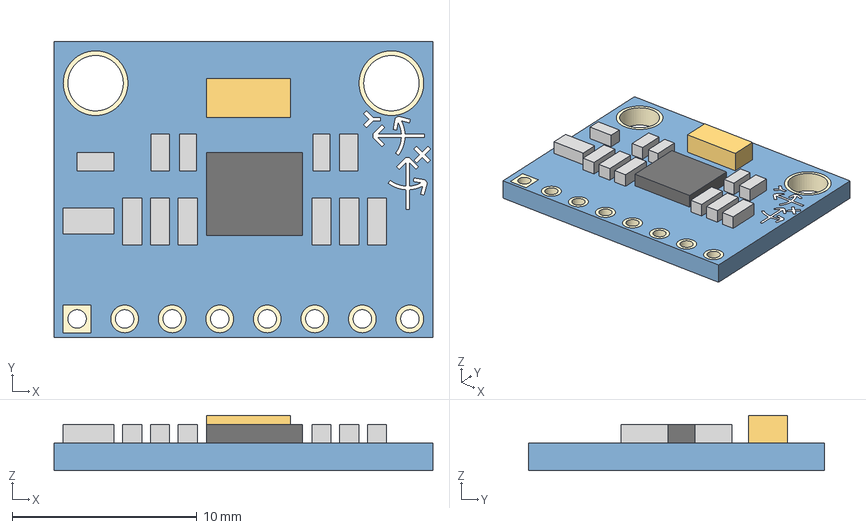
[picture p44: CAD file, 2023-12-13]
LaMuleV1/PCB/LaMulog_esp_compact/3Dmodels/MPU_6050.step
20.5 x 16.0 x 3.00 mm
