pepelepoisson/LaMule/LaMuleV1/PCB/LaMulog_esp_compact/3Dmodels/OpenLog/Components/Fusion001.sldprt

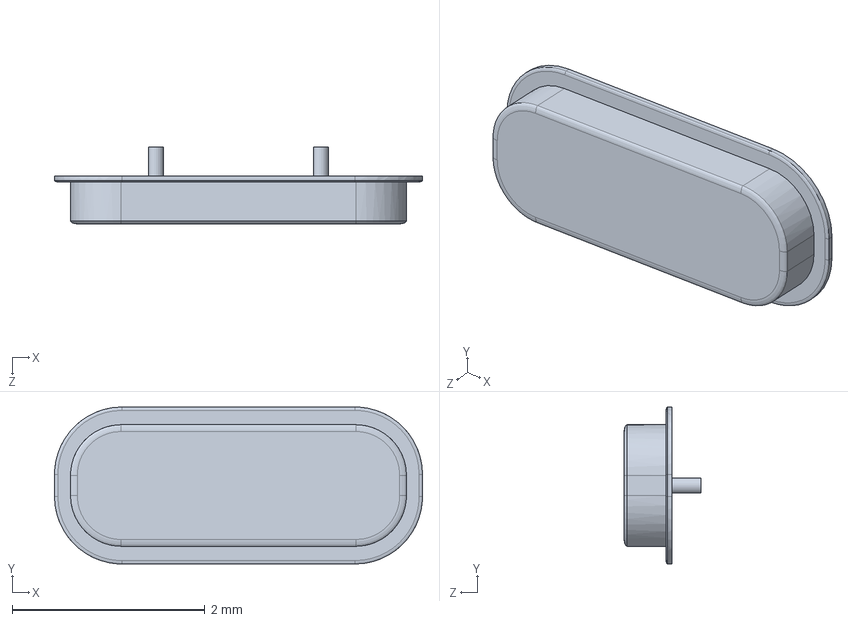
[picture p45: CAD file, 2023-12-13]
LaMuleV1/PCB/LaMulog_esp_compact/3Dmodels/OpenLog/Components/Fusion001.sldprt
3.82 x 1.63 x 0.795 mm
