pepelepoisson/LaMule/LaMuleV1/PCB/LaMulog_esp_compact/3Dmodels/stp/SW-DTSA-63K-V.stp

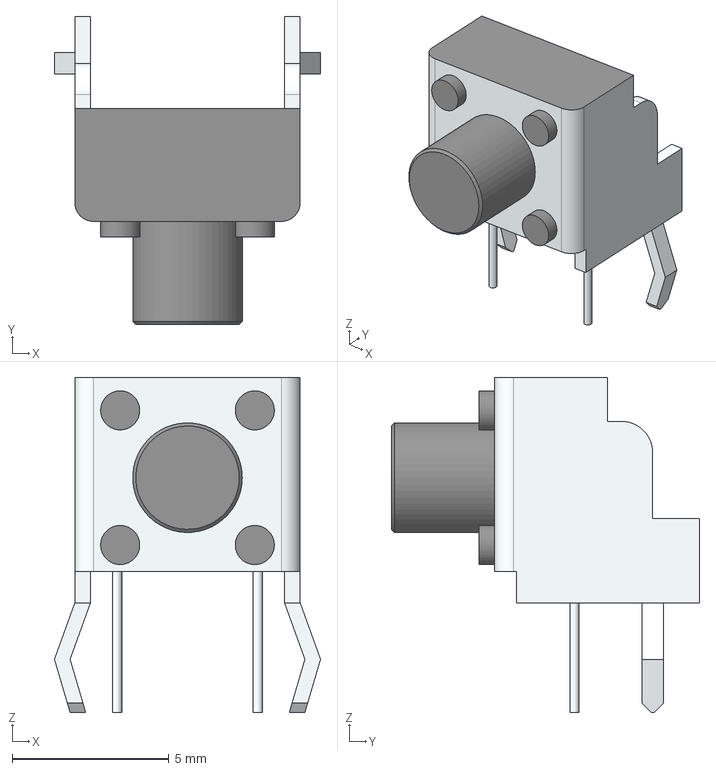
[picture p46: CAD file, 2023-12-13]
LaMuleV1/PCB/LaMulog_esp_compact/3Dmodels/stp/SW-DTSA-63K-V.stp
8.50 x 9.85 x 10.7 mm
