pepelepoisson/LaMule/LaMuleV1/PCB/LaMulog_esp_compact/3Dmodels/bmp280_module.stp

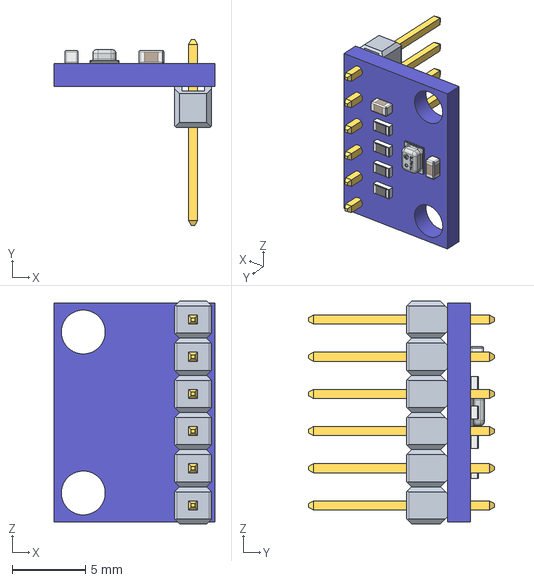
[picture p47: CAD file, 2023-12-13]
LaMuleV1/PCB/LaMulog_esp_compact/3Dmodels/bmp280_module.stp
11.0 x 12.7 x 15.2 mm
