pepelepoisson/LaMule/LaMuleV1/PCB/LaMulog_esp_compact/3Dmodels/OpenLog/Components/solder.SLDPRT

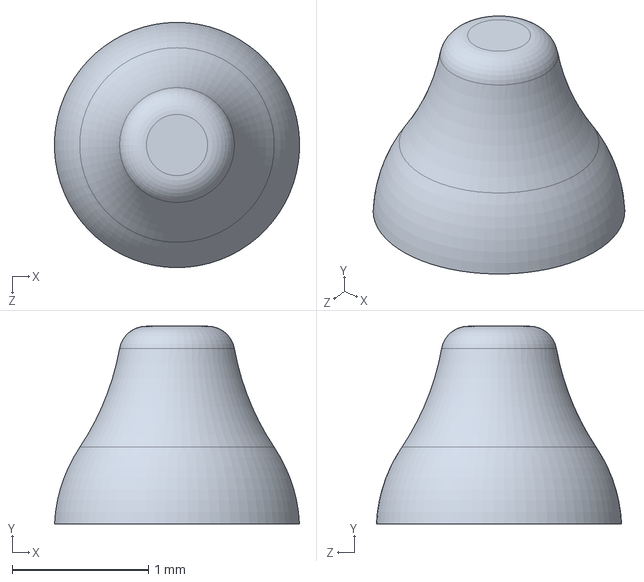
[picture p48: CAD file, 2023-12-13]
LaMuleV1/PCB/LaMulog_esp_compact/3Dmodels/OpenLog/Components/solder.SLDPRT
1.80 x 1.45 x 1.80 mm
