pepelepoisson/LaMule/LaMuleV1/PCB/LaMulog_esp_compact/3Dmodels/stp/SW-DTSA-61K-V.stp

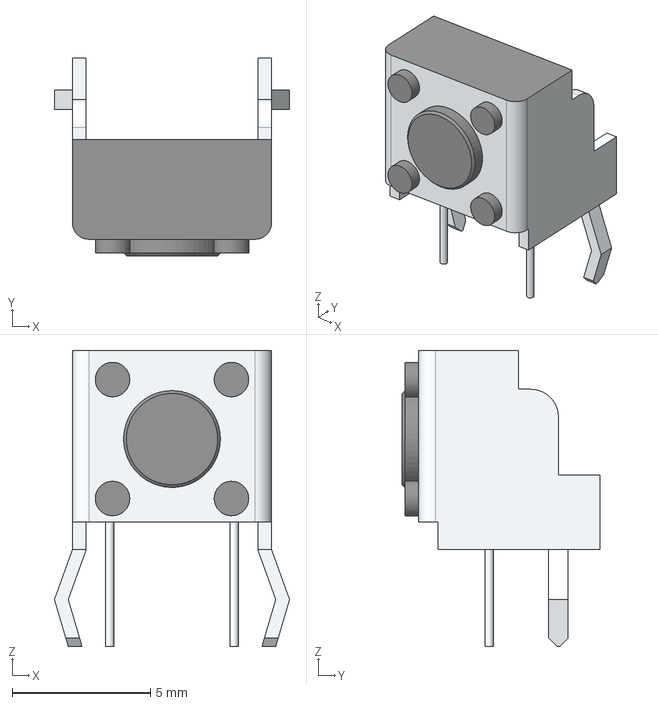
[picture p49: CAD file, 2023-12-13]
LaMuleV1/PCB/LaMulog_esp_compact/3Dmodels/stp/SW-DTSA-61K-V.stp
8.50 x 7.15 x 10.7 mm
