pepelepoisson/LaMule/LaMuleV1/CAD/stl files/LaMule_fixation_lest.stl

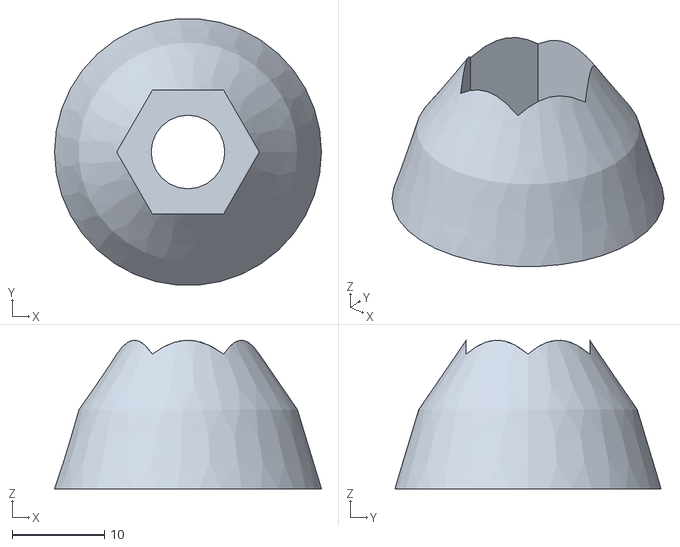
[picture p50: CAD file, 2023-12-13]
LaMuleV1/CAD/stl files/LaMule_fixation_lest.stl
29.0 x 28.9 x 16.1
