pepelepoisson/LaMule/LaMuleV1/PCB/LaMulog_esp_compact/3Dmodels/BME280_SENSOR_MODULE.STEP

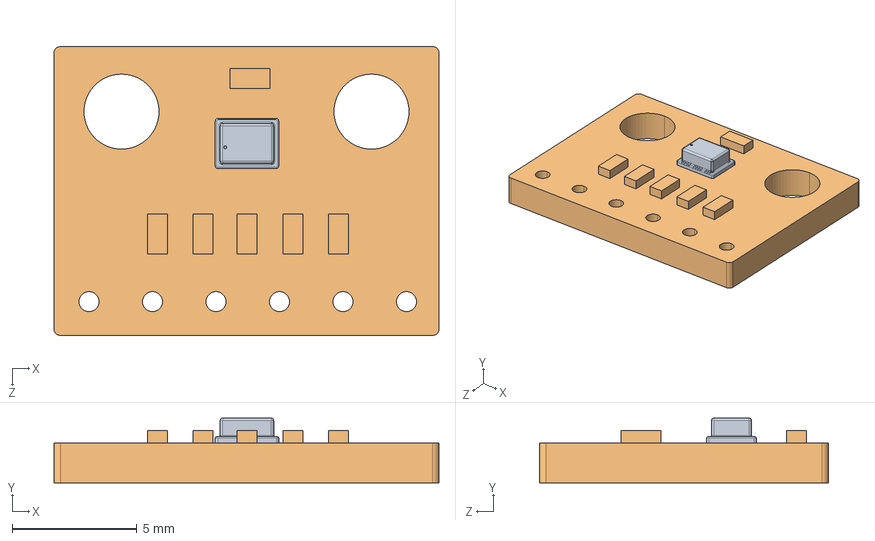
[picture p51: CAD file, 2023-12-13]
LaMuleV1/PCB/LaMulog_esp_compact/3Dmodels/BME280_SENSOR_MODULE.STEP
15.4 x 2.60 x 11.6 mm
