pepelepoisson/LaMule/LaMuleV1/PCB/LaMulog_esp_compact/3Dmodels/OpenLog/Components/Surface Mount Chip LED 3.2x1.6mm.SLDPRT

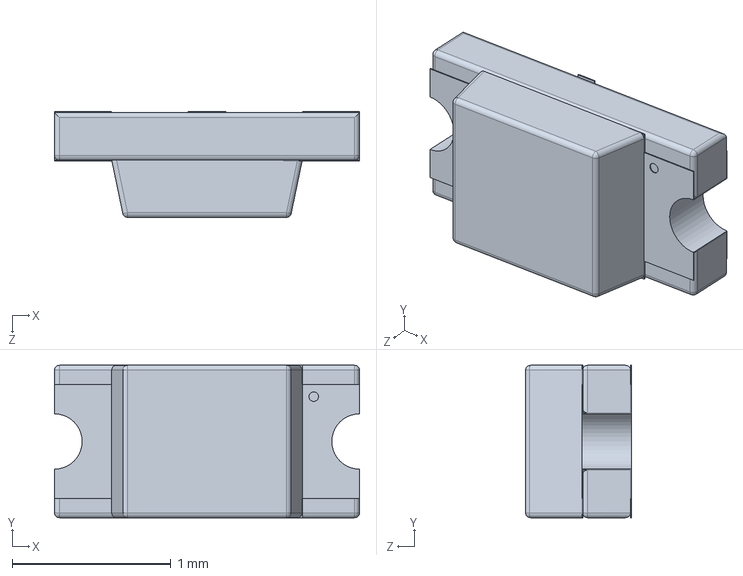
[picture p52: CAD file, 2023-12-13]
LaMuleV1/PCB/LaMulog_esp_compact/3Dmodels/OpenLog/Components/Surface Mount Chip LED 3.2x1.6mm.SLDPRT
1.92 x 0.96 x 0.666 mm
