pepelepoisson/LaMule/LaMuleV1/PCB/LaMulog_esp_compact/3Dmodels/stp/SW-DTSA-62K-V.stp

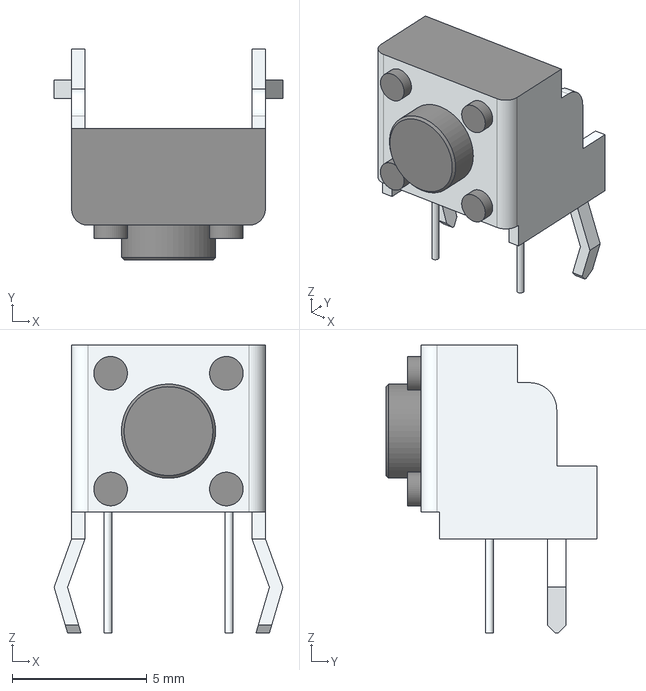
[picture p53: CAD file, 2023-12-13]
LaMuleV1/PCB/LaMulog_esp_compact/3Dmodels/stp/SW-DTSA-62K-V.stp
8.50 x 7.85 x 10.7 mm
