pepelepoisson/LaMule/LaMuleV1/PCB/LaMulog_esp_compact/3Dmodels/OpenLog/Components/cap_603.SLDPRT

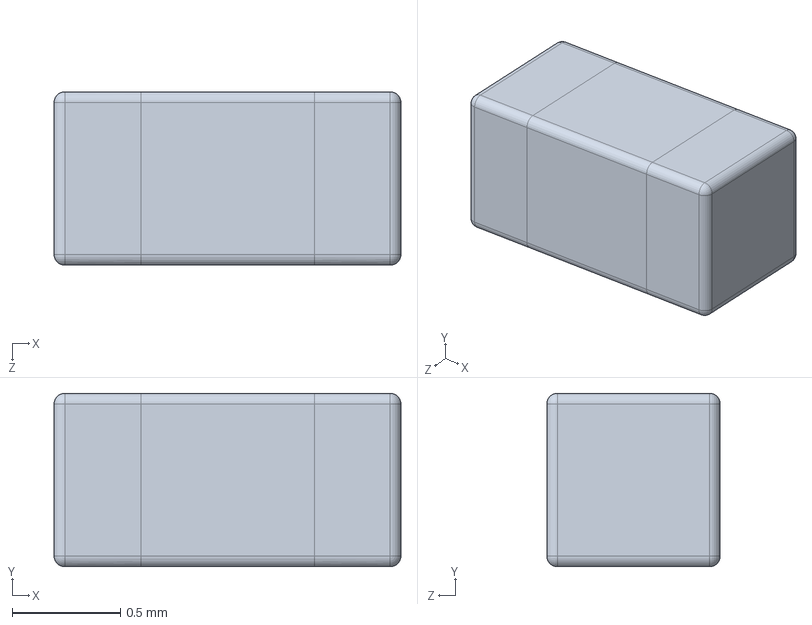
[picture p54: CAD file, 2023-12-13]
LaMuleV1/PCB/LaMulog_esp_compact/3Dmodels/OpenLog/Components/cap_603.SLDPRT
1.60 x 0.8 x 0.8 mm
