pepelepoisson/LaMule/LaMuleV1/PCB/LaMulog_esp_compact/3Dmodels/Switch.stp

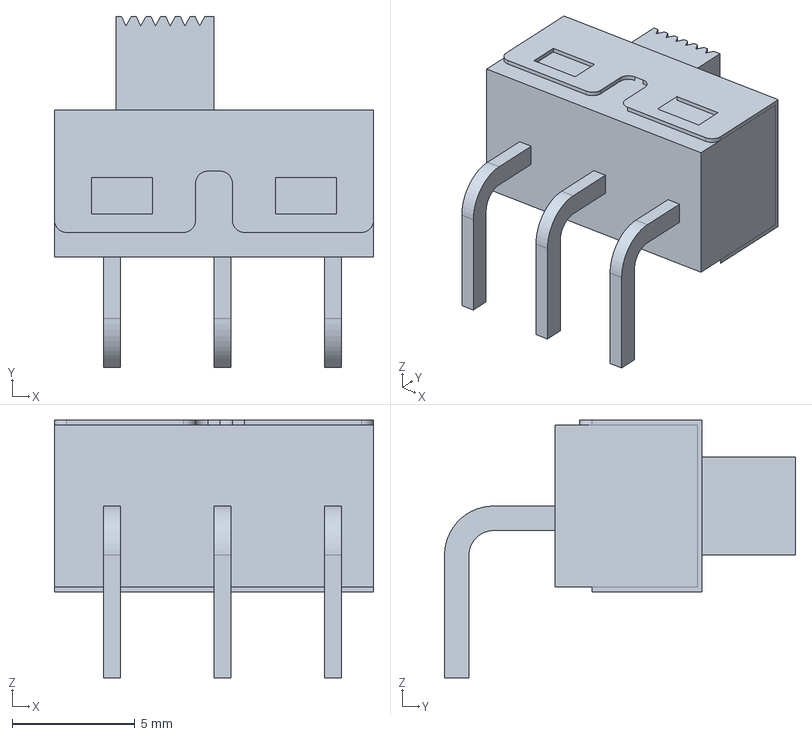
[picture p55: CAD file, 2023-12-13]
LaMuleV1/PCB/LaMulog_esp_compact/3Dmodels/Switch.stp
13.0 x 14.3 x 10.5 mm
