pepelepoisson/LaMule/LaMuleV1/CAD/stl files/LaMule_V1-couvercle_coiffe_V2.stl

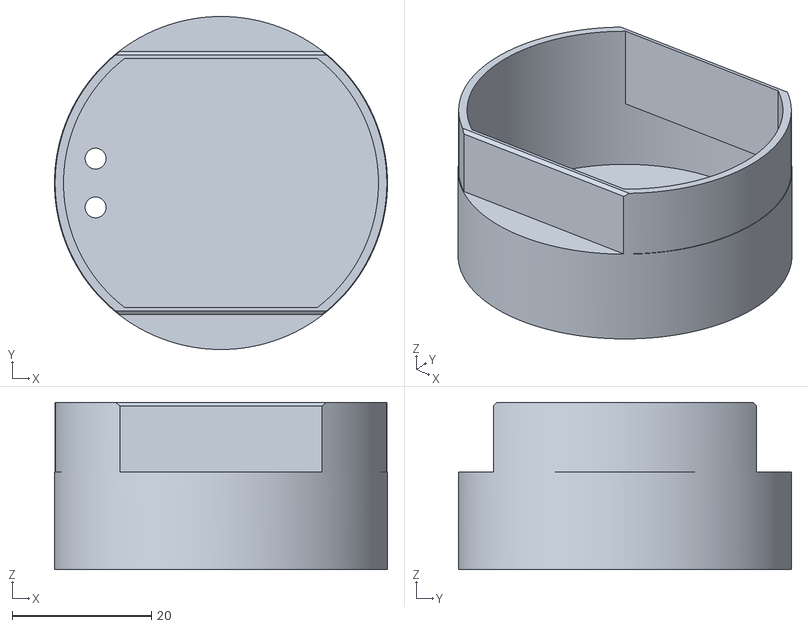
[picture p56: CAD file, 2023-12-13]
LaMuleV1/CAD/stl files/LaMule_V1-couvercle_coiffe_V2.stl
47.8 x 47.8 x 24.0
