pepelepoisson/LaMule/LaMuleV1/PCB/LaMulog_esp_compact/3Dmodels/BME280_SENSOR_MODULE_WITH_HEADER.STEP

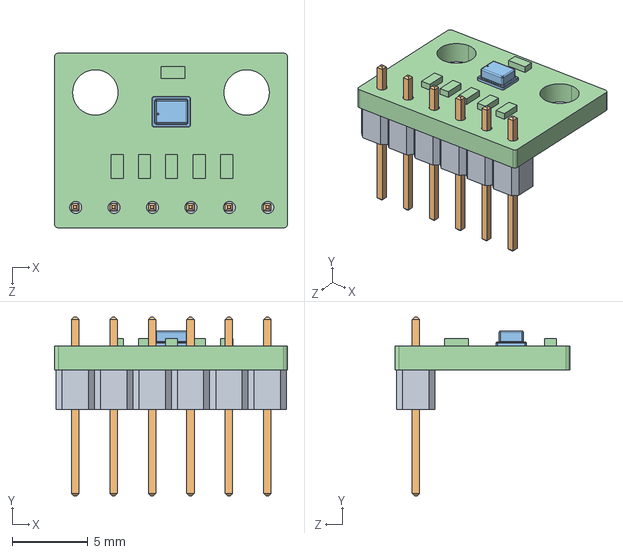
[picture p57: CAD file, 2023-12-13]
LaMuleV1/PCB/LaMulog_esp_compact/3Dmodels/BME280_SENSOR_MODULE_WITH_HEADER.STEP
15.4 x 11.8 x 11.6 mm
