pepelepoisson/LaMule/LaMuleV1/CAD/stl files/LaMule_adaptateur_moteur_V1.stl

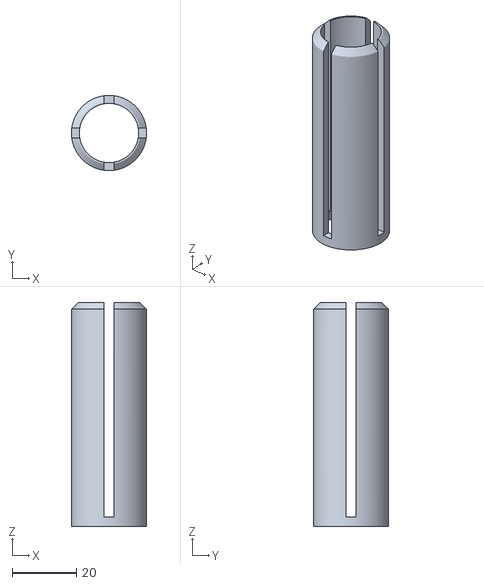
[picture p59: CAD file, 2023-12-13]
LaMuleV1/CAD/stl files/LaMule_adaptateur_moteur_V1.stl
23.5 x 23.5 x 70.0
