pepelepoisson/LaMule/LaMuleV1/PCB/LaMulog_esp_compact/3Dmodels/OpenLog/Components/SOT23-5.SLDPRT

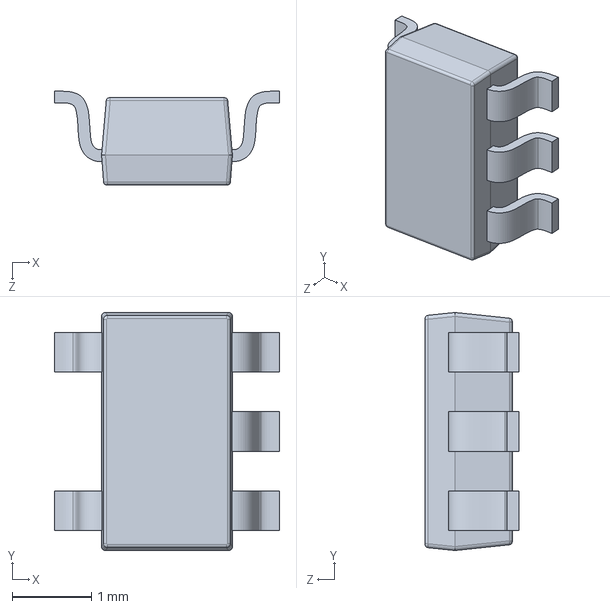
[picture p60: CAD file, 2023-12-13]
LaMuleV1/PCB/LaMulog_esp_compact/3Dmodels/OpenLog/Components/SOT23-5.SLDPRT
2.84 x 3.00 x 1.18 mm
