pepelepoisson/LaMule/LaMuleV1/CAD/stl files/LaMule_fixation_elecronique_V3.stl

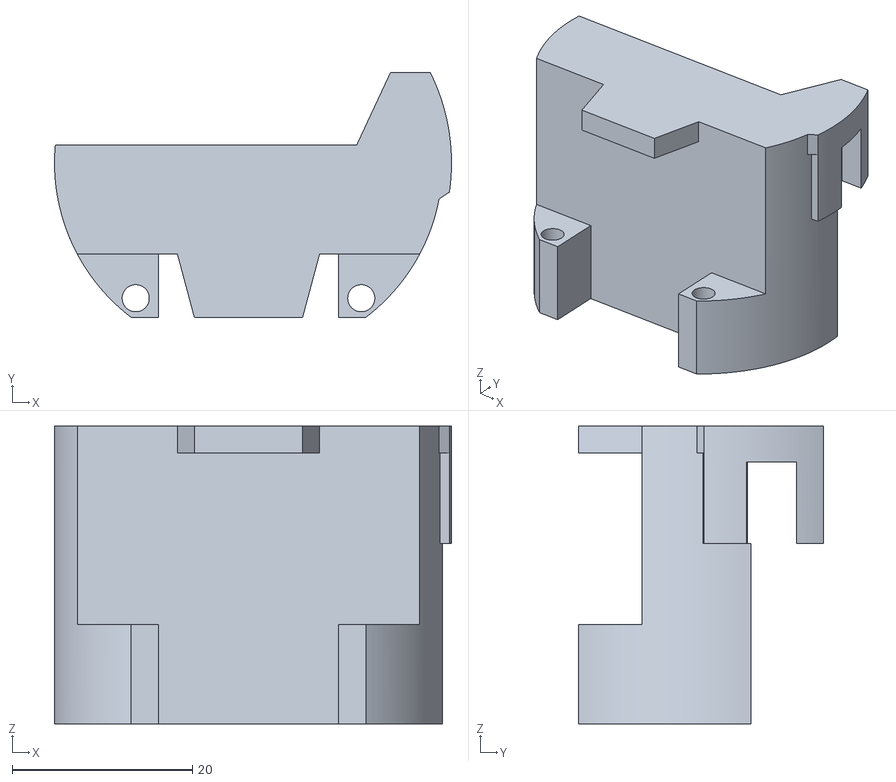
[picture p61: CAD file, 2023-12-13]
LaMuleV1/CAD/stl files/LaMule_fixation_elecronique_V3.stl
44.0 x 27.1 x 33.0
