pepelepoisson/LaMule/LaMuleV1/CAD/stl files/LaMule_support_ailerons_V1.stl

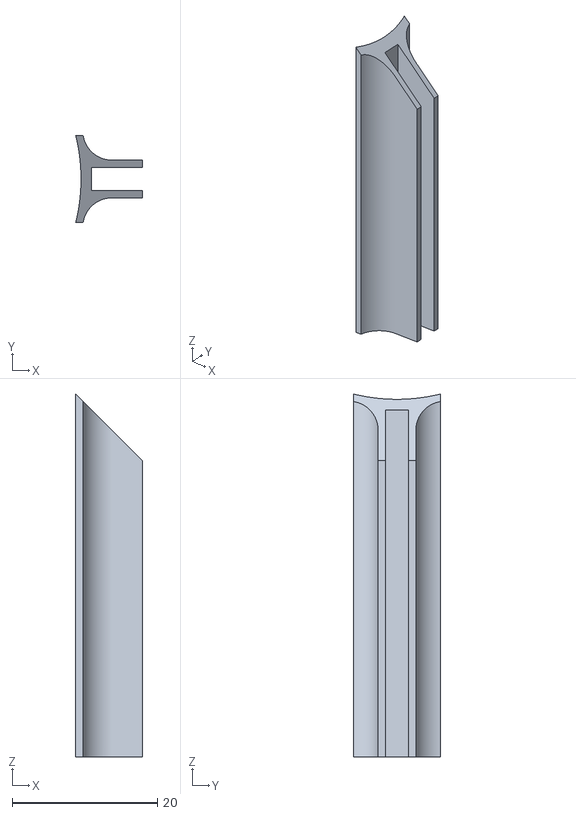
[picture p63: CAD file, 2023-12-13]
LaMuleV1/CAD/stl files/LaMule_support_ailerons_V1.stl
9.18 x 12.0 x 50.0
