pepelepoisson/LaMule/LaMuleV1/CAD/stl files/LaMule_couvercle_coiffe_V8.stl

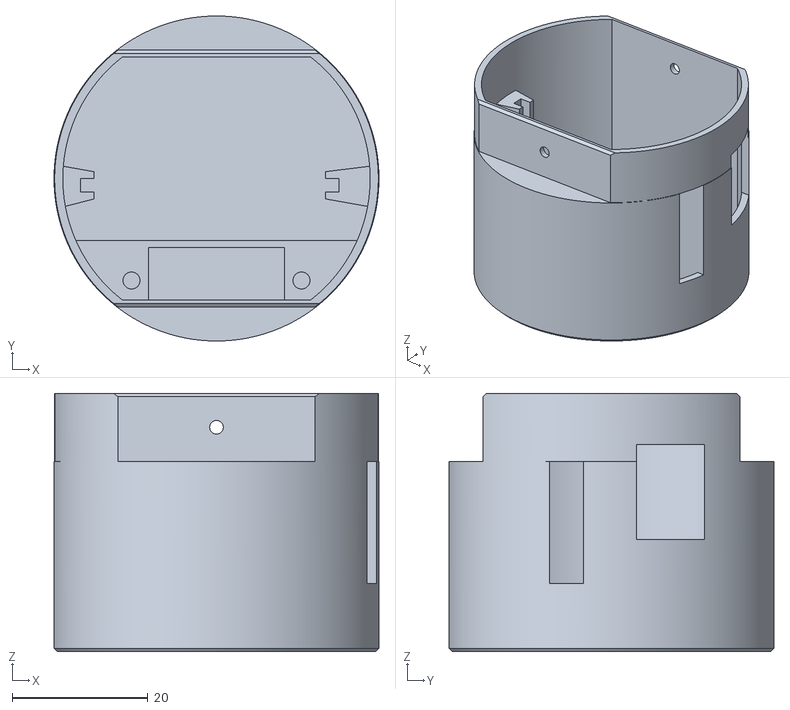
[picture p64: CAD file, 2023-12-13]
LaMuleV1/CAD/stl files/LaMule_couvercle_coiffe_V8.stl
47.8 x 47.8 x 38.0
