pepelepoisson/LaMule/LaMuleV1/CAD/stl files/LaMule_support_moteur_V1.stl

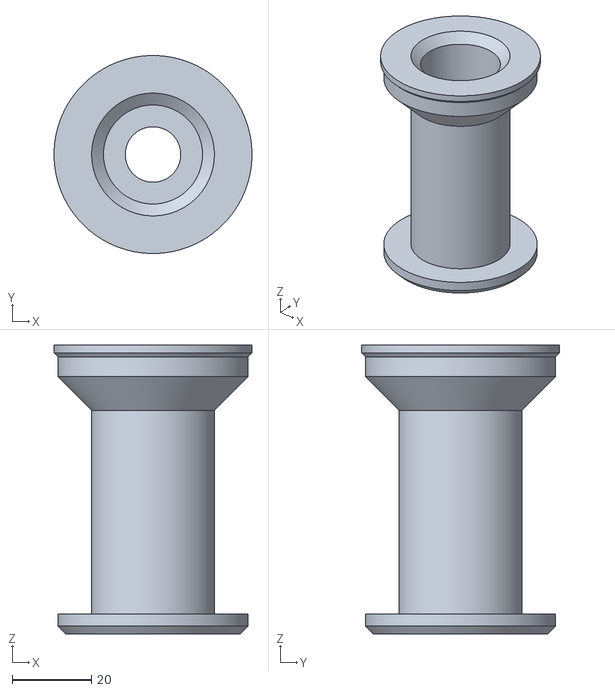
[picture p65: CAD file, 2023-12-13]
LaMuleV1/CAD/stl files/LaMule_support_moteur_V1.stl
50.0 x 50.0 x 73.0
