pepelepoisson/LaMule/(list of files, cad)

Other CAD files:
LaMuleV1/CAD/stl files/LaMule_couvercle_coiffe_V1.stl
LaMuleV1/CAD/stl files/LaMule_couvercle_coiffe_V2.stl
LaMuleV1/CAD/stl files/LaMule_couvercle_coiffe_V3.stl
LaMuleV1/CAD/stl files/LaMule_couvercle_coiffe_V4.stl
LaMuleV1/CAD/stl files/LaMule_couvercle_coiffe_V5.stl
LaMuleV1/CAD/stl files/LaMule_couvercle_coiffe_V6.stl
LaMuleV1/CAD/stl files/LaMule_couvercle_coiffe_V7.stl
LaMuleV1/CAD/stl files/LaMule_fixation_elecronique_V1.stl
LaMuleV1/CAD/stl files/LaMule_fixation_elecronique_V2.stl
LaMuleV1/PCB/LaMulog_esp_compact/3Dmodels/GY-BME/P280, 6-PIN-Version v4.f3d
LaMuleV1/PCB/LaMulog_esp_compact/3Dmodels/MPU_6050.f3d
LaMuleV1/PCB/LaMulog_esp_compact/3Dmodels/MPU_6050.iges
LaMuleV1/PCB/LaMulog_esp_compact/3Dmodels/MPU_6050.stl
LaMuleV1/PCB/LaMulog_esp_compact/3Dmodels/Switch.igs
LaMuleV1/PCB/LaMulog_esp_compact/3Dmodels/Switch.stl
LaMuleV1/PCB/LaMulog_esp_compact/3Dmodels/bmp280_module_Shrinkwrap.ipt
