pepelepoisson/LaMule/LaMuleV1/Flight_data/test_altimetre_V3.png

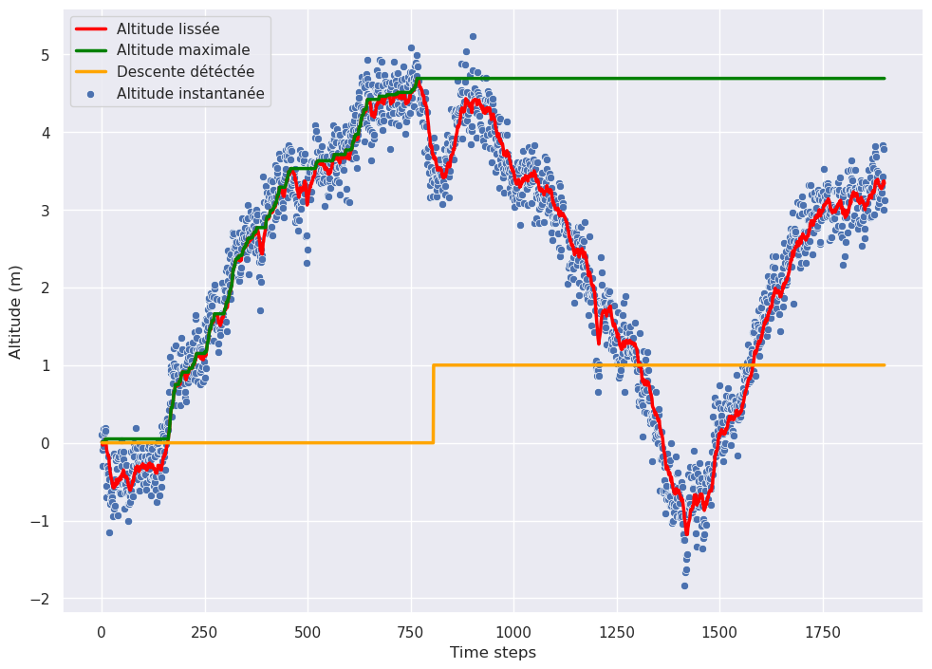
LaMuleV1/Flight_data/test_altimetre_V3.png
