pepelepoisson/LaMule/LaMuleV1/Images/test_altimetre_V1.png

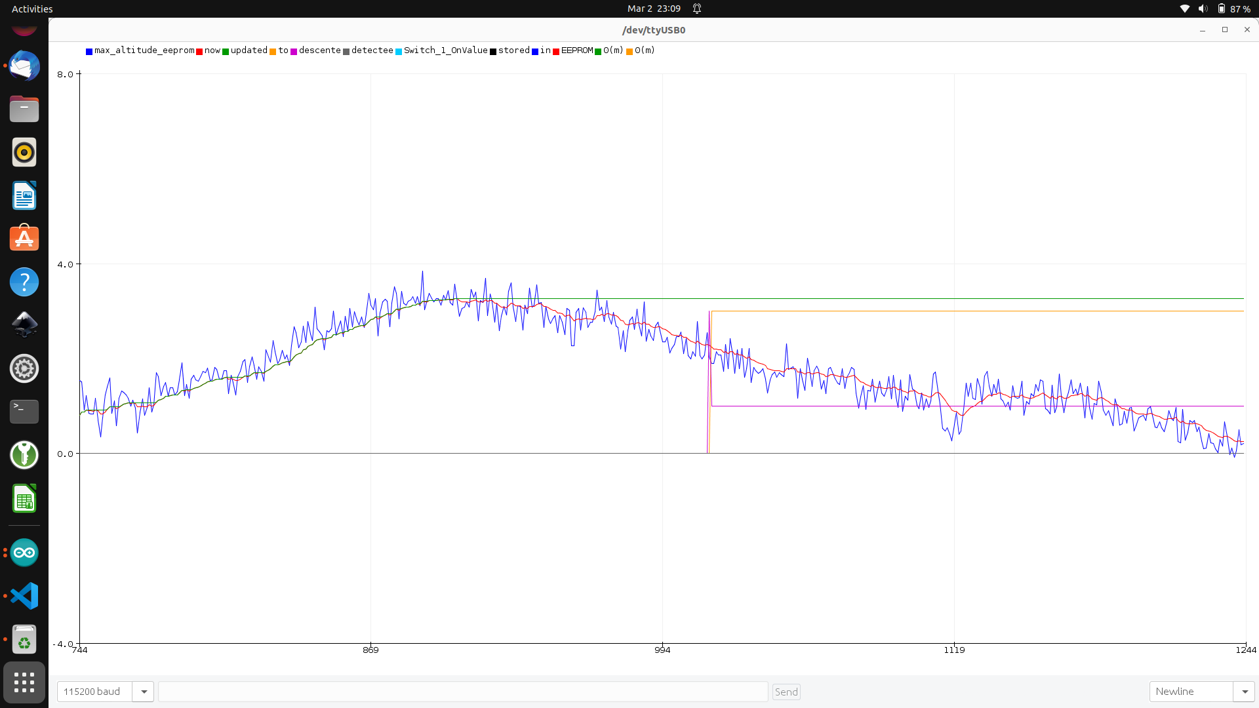
LaMuleV1/Images/test_altimetre_V1.png
