pepelepoisson/LaMule/LaMuleV1/Images/LaMule_V1_Dessin_Technique.pdf

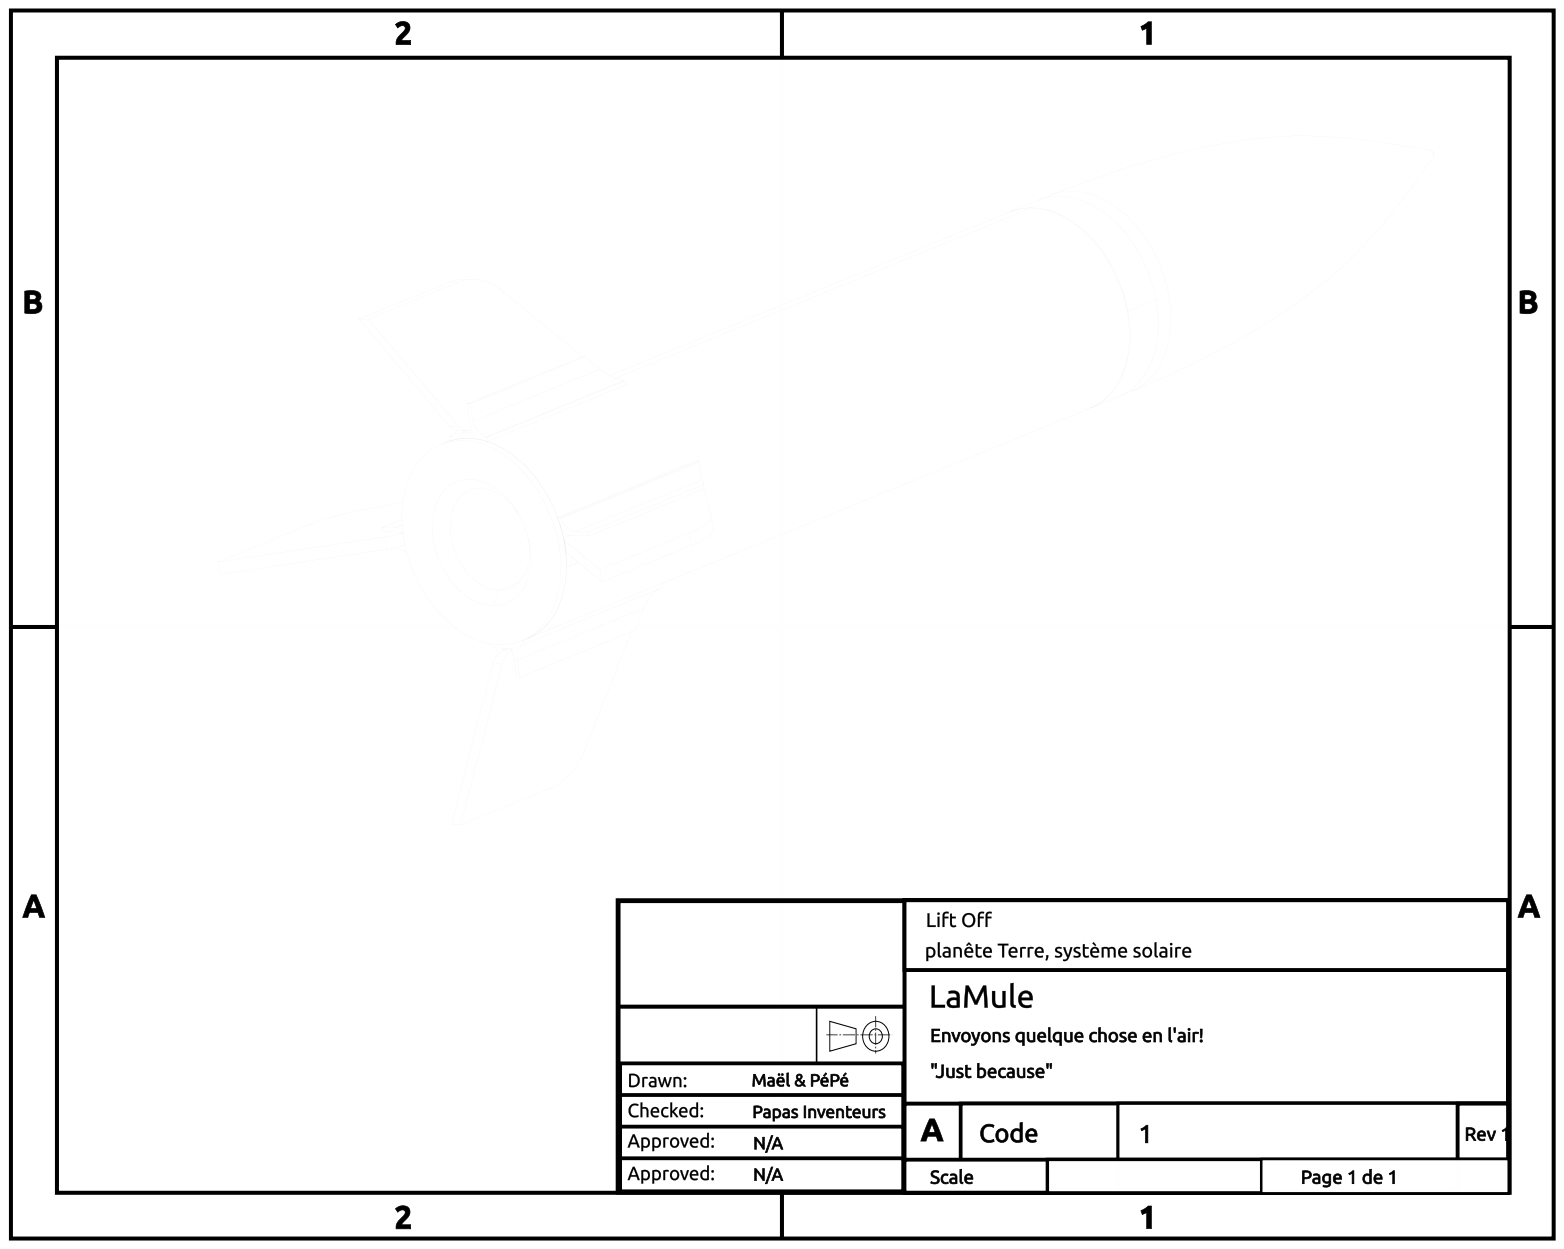
[picture p68: page 1]
