pepelepoisson/LaMule/LaMuleV1/CAD/Other/CAD.pdf

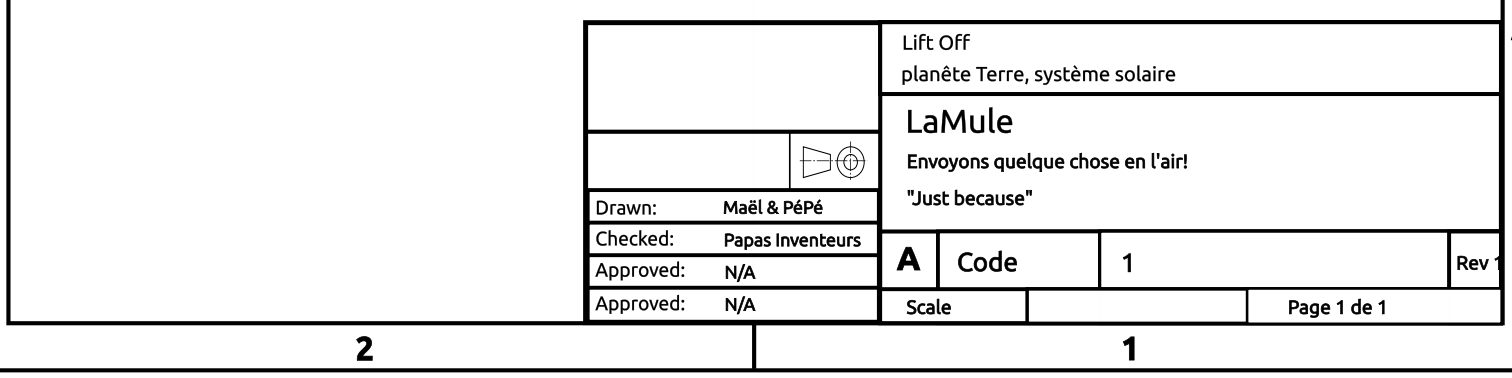
[picture p69: page 1]
