pepelepoisson/LaMule/(list of files, drawings)

Other design files:
LaMuleV1/PCB/LaMulog_esp_compact/freerouting.dsn
LaMuleV1/PCB/LaMulog_esp_compact/temp-freerouting.dsn
