pepelepoisson/LaMule/LaMuleV1/PCB/LaMulog_esp_compact/LaMulog.kicad_pcb

## KiCad design LaMuleV1/PCB/LaMulog_esp_compact/LaMulog.kicad_pcb (2023-12-13)

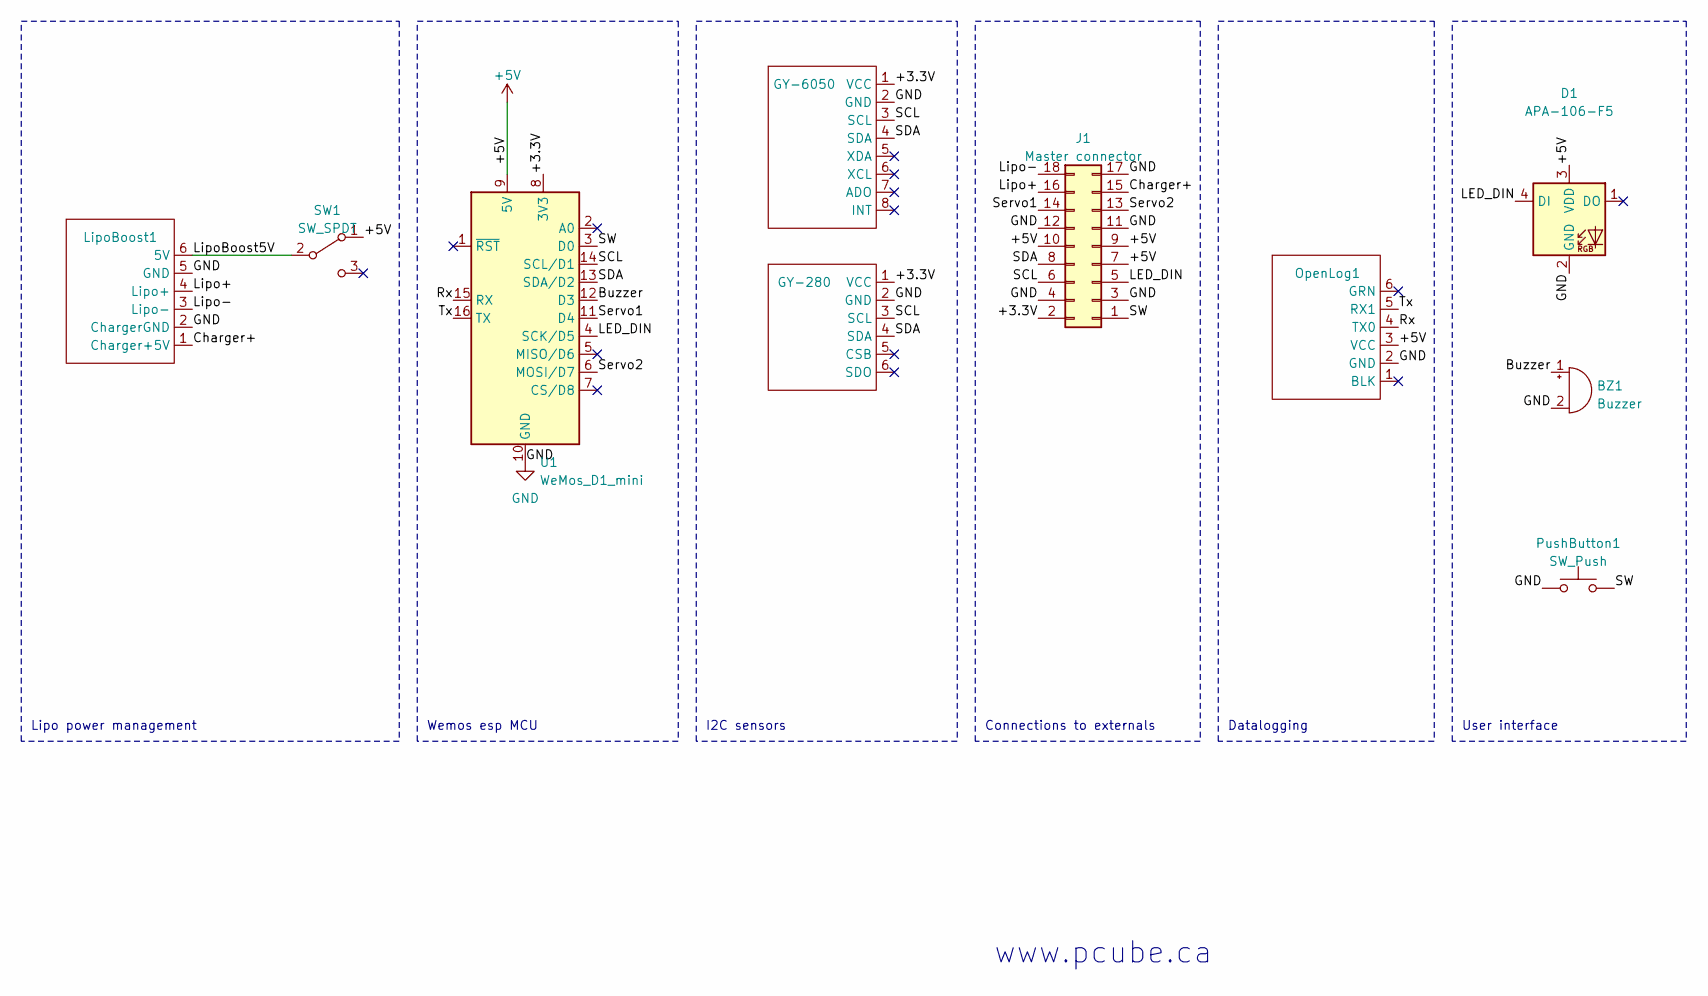
[picture p70: schematic LaMulog.kicad_sch, LaMulog_esp]

Parts:
BZ1: Buzzer; Buzzer_12x9.5RM7.6
D1: APA-106-F5; LED_D5.0mm-4_RGB_Wide_Pins
GY-280: GY-280
GY-6050: GY-6050
J1: Master connector; MasterConnectorVertical
LipoBoost1: LipoBoost1
OpenLog1: OpenLog1
PushButton1: SW_Push; SW_Tactile_SPST_Angled_PTS645Vx39-2LFS
SW1: SW_SPDT; Switch
U1: WeMos_D1_mini; WEMOS_D1_mini_light

Connections:
/+3.3V: GY-280.1 (VCC), GY-6050.1 (VCC), J1.2 (Pin_9a), U1.8 (3V3)
/+5V: D1.3 (VDD), J1.7 (Pin_6b), J1.9 (Pin_5b), J1.10 (Pin_5a), OpenLog1.3 (VCC), SW1.1 (A), U1.9 (5V)
/Buzzer: BZ1.1 (-), U1.12 (D3)
/Charger+: J1.15 (Pin_2b), LipoBoost1.1 (Charger+5V)
/LED_DIN: D1.4 (DI), J1.5 (Pin_7b), U1.4 (SCK/D5)
/Lipo+: J1.16 (Pin_2a), LipoBoost1.4 (Lipo+)
/Lipo-: J1.18 (Pin_1a), LipoBoost1.3 (Lipo-)
/LipoBoost5V: LipoBoost1.6 (5V), SW1.2 (B)
/Rx: OpenLog1.4 (TX0), U1.15 (RX)
/SCL: GY-280.3 (SCL), GY-6050.3 (SCL), J1.6 (Pin_7a), U1.14 (SCL/D1)
/SDA: GY-280.4 (SDA), GY-6050.4 (SDA), J1.8 (Pin_6a), U1.13 (SDA/D2)
/SW: J1.1 (Pin_9b), PushButton1.2, U1.3 (D0); also elsewhere on the board
/Servo1: J1.14 (Pin_3a), U1.11 (D4)
/Servo2: J1.13 (Pin_3b), U1.6 (MOSI/D7)
/Tx: OpenLog1.5 (RX1), U1.16 (TX)
GND: BZ1.2 (+), D1.2 (GND), GY-280.2 (GND), GY-6050.2 (GND), J1.3 (Pin_8b), J1.4 (Pin_8a), J1.11 (Pin_4b), J1.12 (Pin_4a), J1.17 (Pin_1b), LipoBoost1.2 (ChargerGND), LipoBoost1.5 (GND), OpenLog1.2 (GND), PushButton1.1, U1.10 (GND); also elsewhere on the board

Notes on the sheet:
Datalogging
Lipo power management
www.pcube.ca
User interface
Wemos esp MCU
I2C sensors
Connections to externals

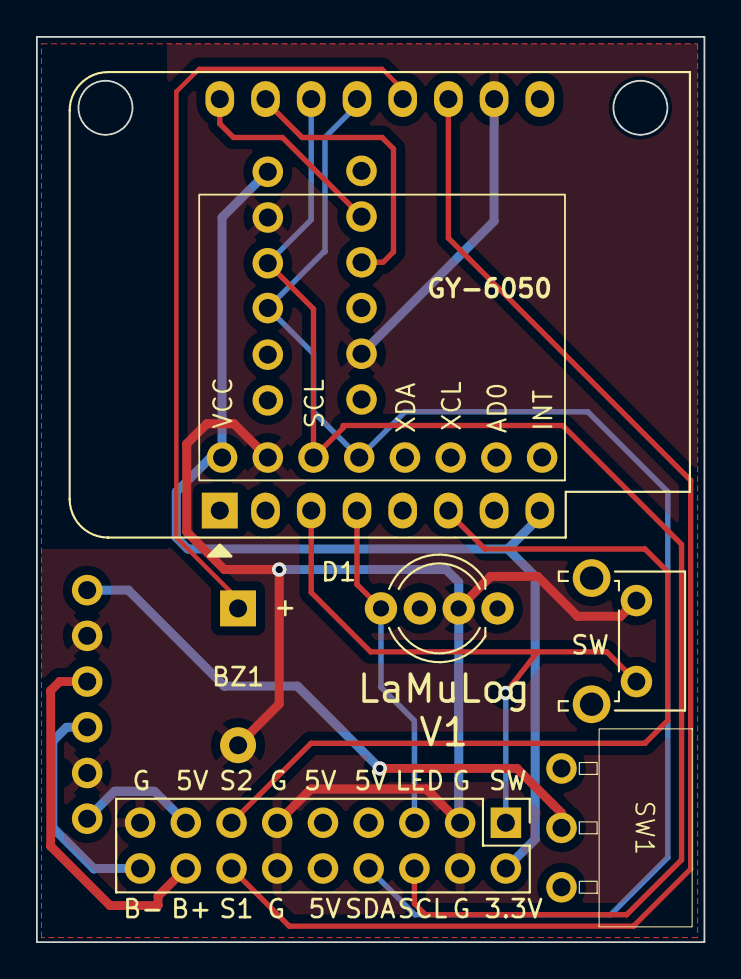
[picture p71: board LaMulog.kicad_pcb from above]

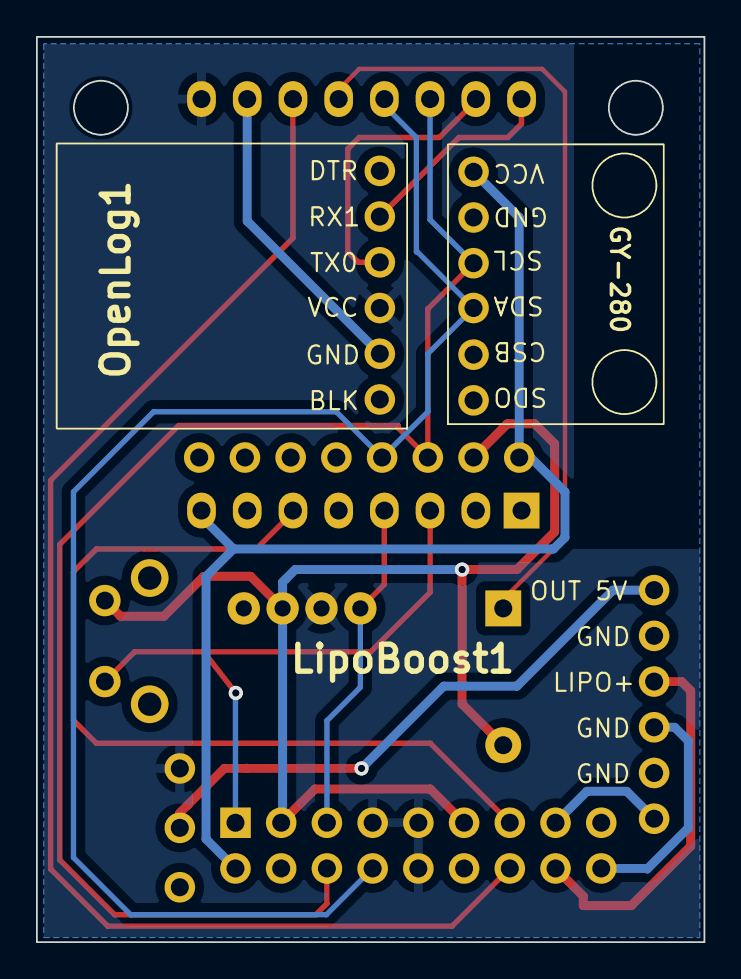
[picture p72: board LaMulog.kicad_pcb from below]

Board: 2 copper layers, 37.1 x 50.3 mm, 10 parts (3 on the bottom side), 16 nets.

Other parts of the board:
SW: SW_Push; SW_Tactile_SPST_Angled_PTS645Vx39-2LFS

Their connections:
/SW: SW.2; also elsewhere on the board
GND: SW.1; also elsewhere on the board
