pepelepoisson/LaMule/LaMuleV1/Code/config.txt

115200,26,3,1,1,1,0
baud,escape,esc#,mode,verb,echo,ignoreRX
